CharlieProjects/MULTI-19/03 Electronics/Components Datasheet/02 Conveyor controller/GoldenMotor/VEC Controller Wiring Diagram.jpg

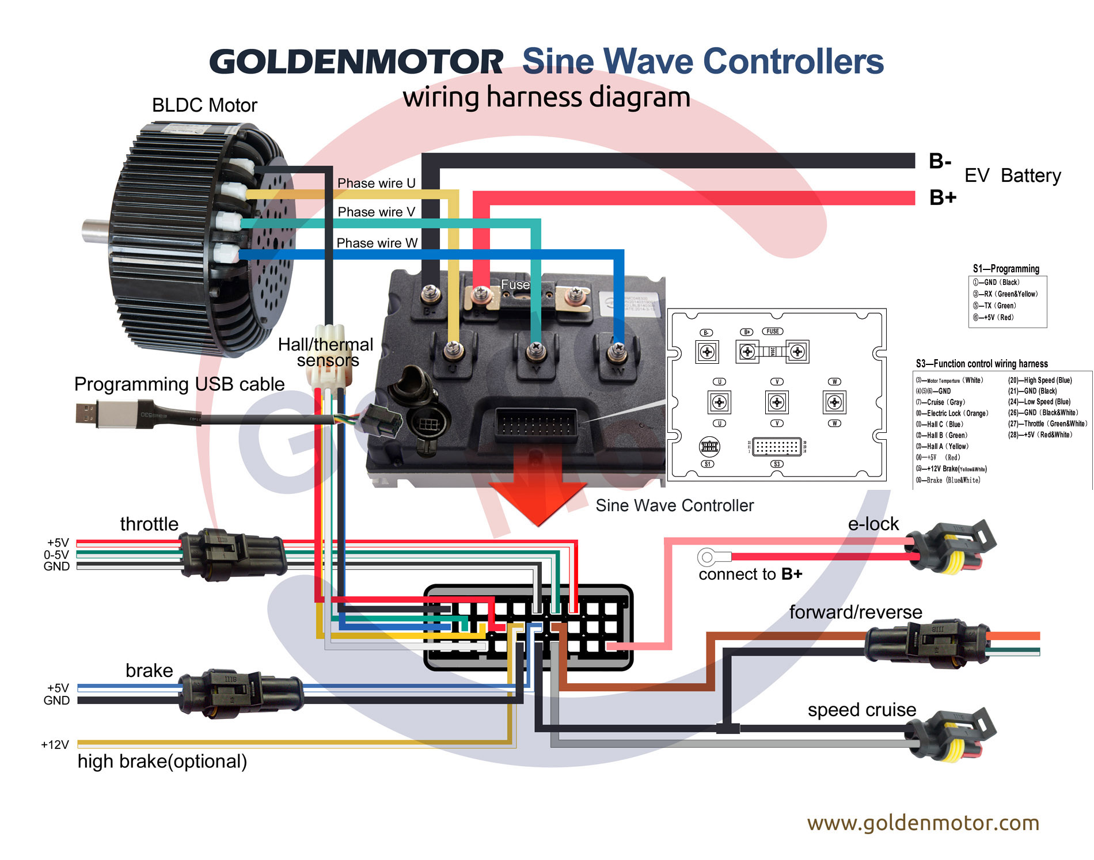
03 Electronics/Components Datasheet/02 Conveyor controller/GoldenMotor/VEC Controller Wiring Diagram.jpg
