CharlieProjects/MULTI-19/01 CAD/01 Main Model/01 Original/01 Main Model/Torno_rodillos/ELECTRONICA/arduino-nano-shield-cnc-1.snapshot.4 (1)/nano shield.png

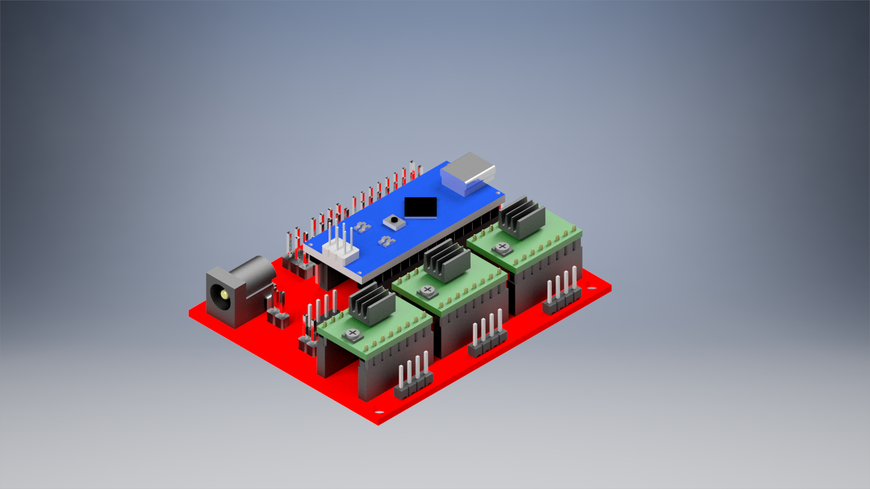
01 CAD/01 Main Model/01 Original/01 Main Model/Torno_rodillos/ELECTRONICA/arduino-nano-shield-cnc-1.snapshot.4 (1)/nano shield.png
