CharlieProjects/MULTI-19/README.md

# MULTI-19
This repository intends to organize the files related to the control of the conveyor belt of Multiplo Colombia S.A.S

[REPO](https://github.com/CharlieProjects/MULTI-19)

## Intro
