CharlieProjects/MULTI-19/00 Documents/05 Pictures/CONVEYOR v2.png

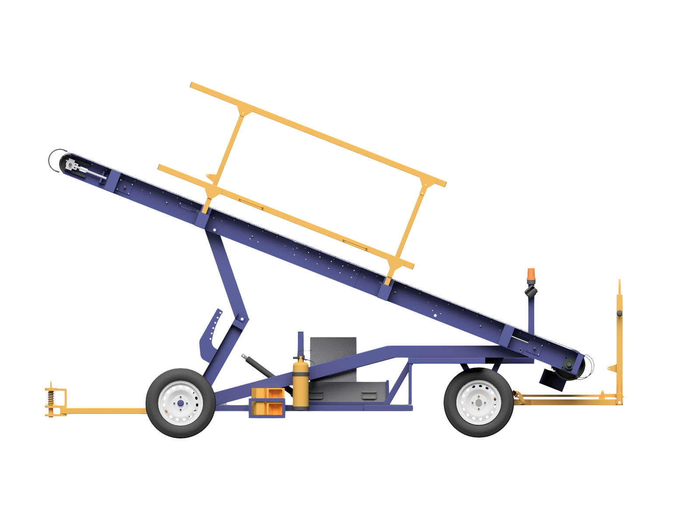
00 Documents/05 Pictures/CONVEYOR v2.png
