CharlieProjects/MULTI-19/00 Documents/05 Pictures/recorte_de pantalla-1.png

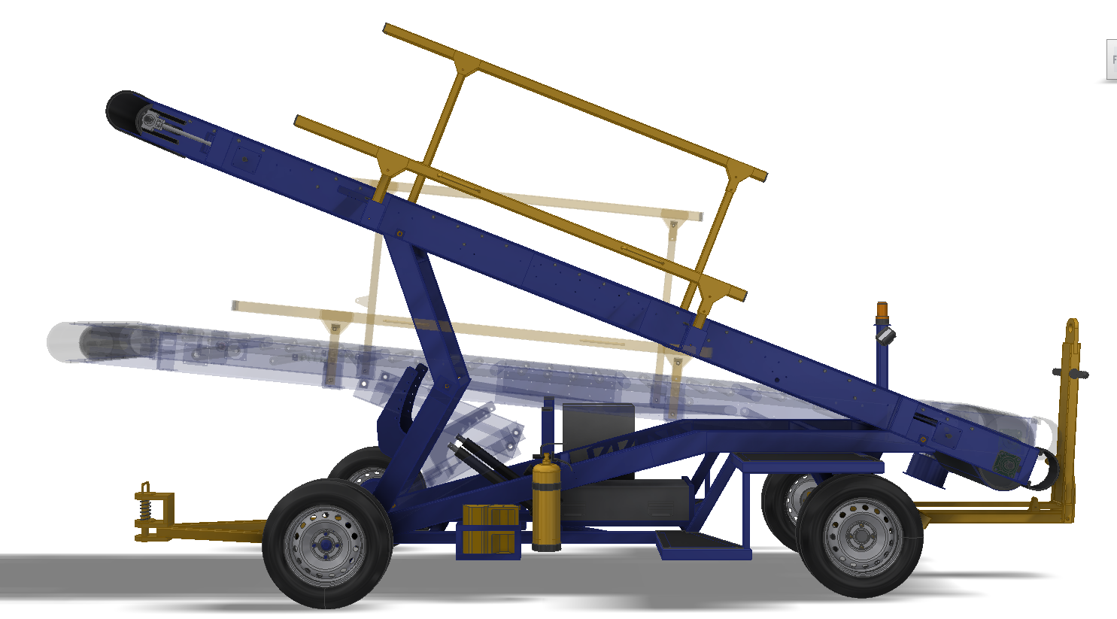
00 Documents/05 Pictures/recorte_de pantalla-1.png
