CharlieProjects/MULTI-19/00 Documents/05 Pictures/recorte_de pantalla-7.png

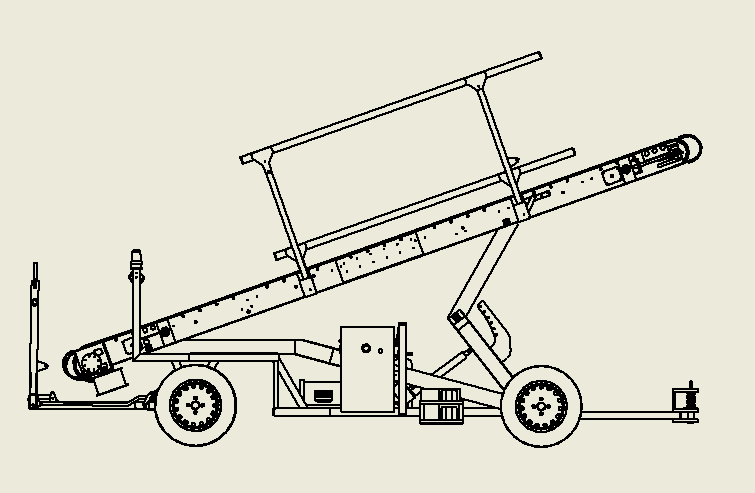
00 Documents/05 Pictures/recorte_de pantalla-7.png
