CharlieProjects/MULTI-19/00 Documents/05 Pictures/Untitled picture.png

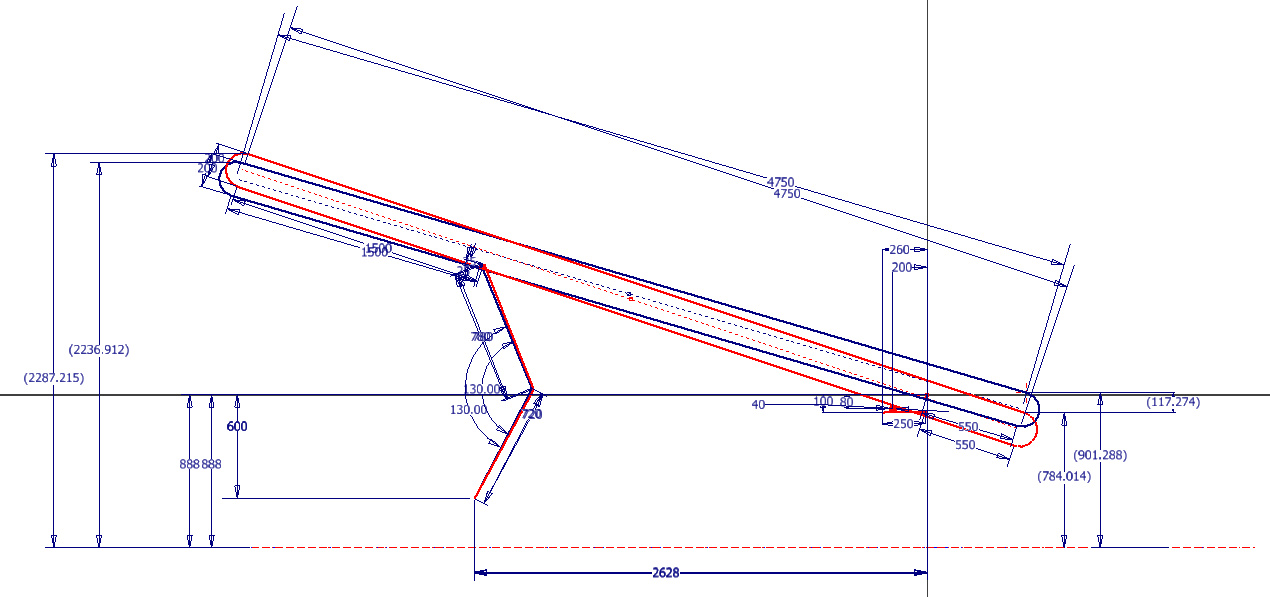
00 Documents/05 Pictures/Untitled picture.png
