CharlieProjects/MULTI-19/01 CAD/01 Main Model/01 Original/01 Main Model/Torno_rodillos/chinese-cnc-rotation-axis-module-with-80mm-chuck-1.snapshot.5/globe bot/80mm-CNC-4th-Axis-CNC-dividing-head-Rotation-Axis-A-axis-kit-for-Mini-CNC-router.jpg

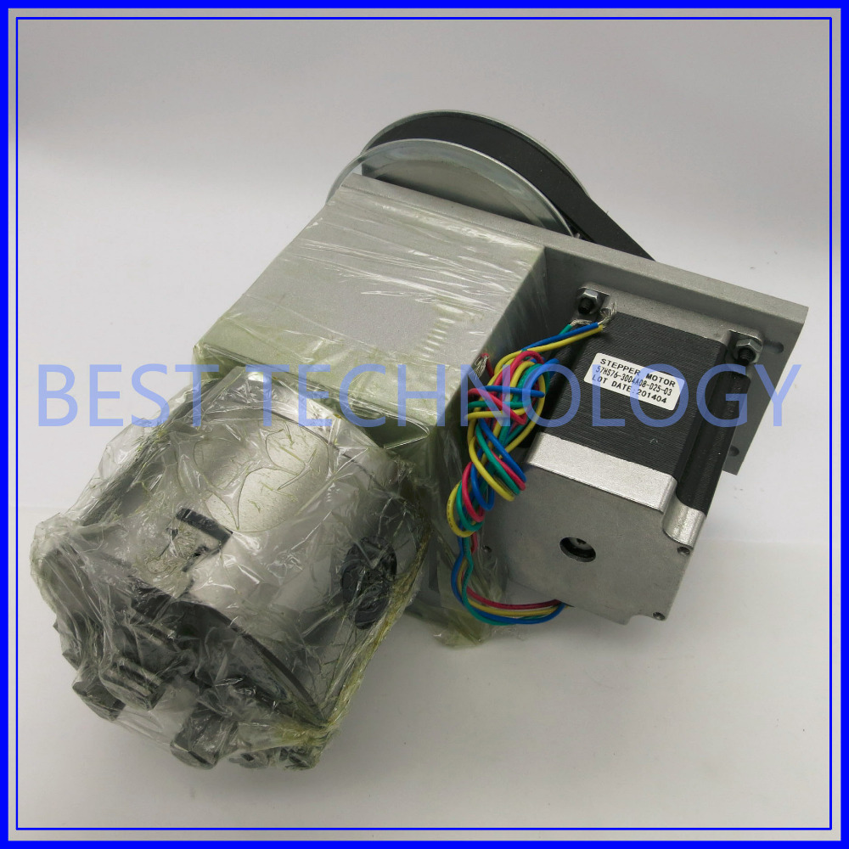
01 CAD/01 Main Model/01 Original/01 Main Model/Torno_rodillos/chinese-cnc-rotation-axis-module-with-80mm-chuck-1.snapshot.5/globe bot/80mm-CNC-4th-Axis-CNC-dividing-head-Rotation-Axis-A-axis-kit-for-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
