CharlieProjects/MULTI-19/01 CAD/01 Main Model/01 Original/01 Main Model/Torno_rodillos/chinese-cnc-rotation-axis-module-with-80mm-chuck-1.snapshot.5/globe bot/A_axis_right.JPG

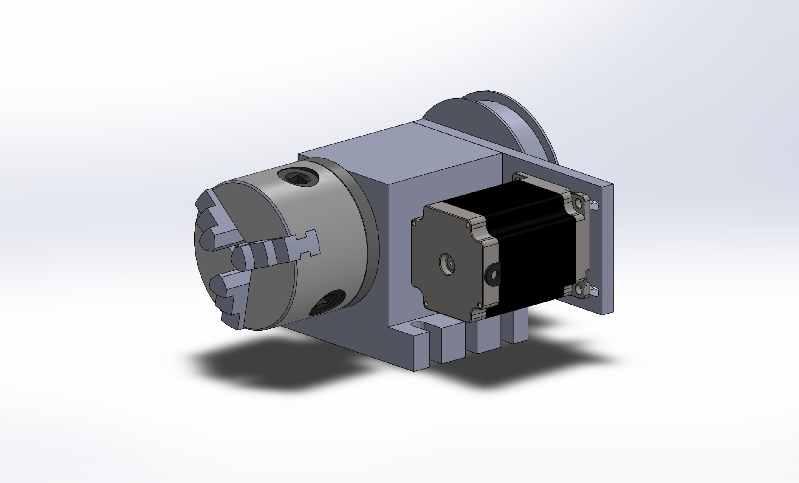
01 CAD/01 Main Model/01 Original/01 Main Model/Torno_rodillos/chinese-cnc-rotation-axis-module-with-80mm-chuck-1.snapshot.5/globe bot/A_axis_right.JPG
