CharlieProjects/MULTI-19/01 CAD/01 Main Model/01 Original/01 Main Model/Torno_rodillos/ELECTRONICA/Pulse power supply/Dimension.jpg

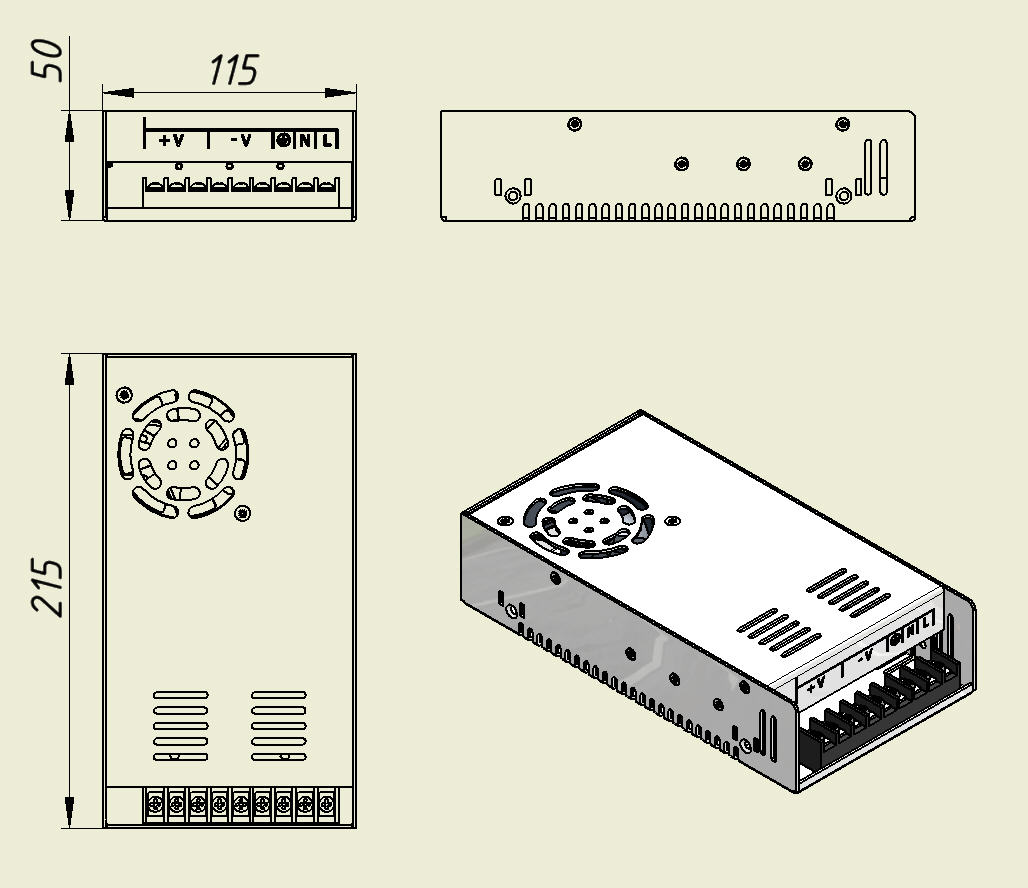
01 CAD/01 Main Model/01 Original/01 Main Model/Torno_rodillos/ELECTRONICA/Pulse power supply/Dimension.jpg
