CharlieProjects/MULTI-19/01 CAD/01 Main Model/01 Original/01 Main Model/Torno_rodillos/ELECTRONICA/Rotary Encoder EC11/Renders/EC11_knob.png

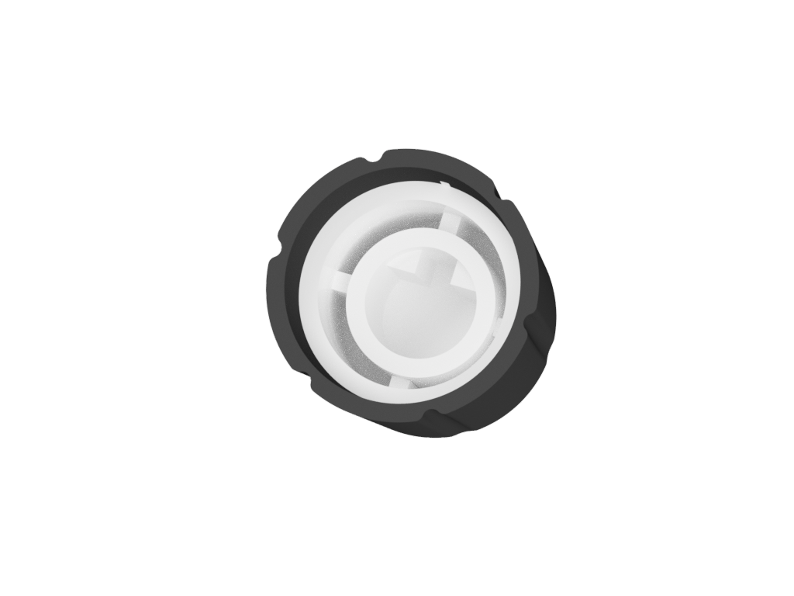
01 CAD/01 Main Model/01 Original/01 Main Model/Torno_rodillos/ELECTRONICA/Rotary Encoder EC11/Renders/EC11_knob.png
