CharlieProjects/MULTI-19/01 CAD/01 Main Model/01 Original/01 Main Model/Torno_rodillos/ELECTRONICA/SMAKN TB6600 STEPPER MOTOR DRIVER.JPG

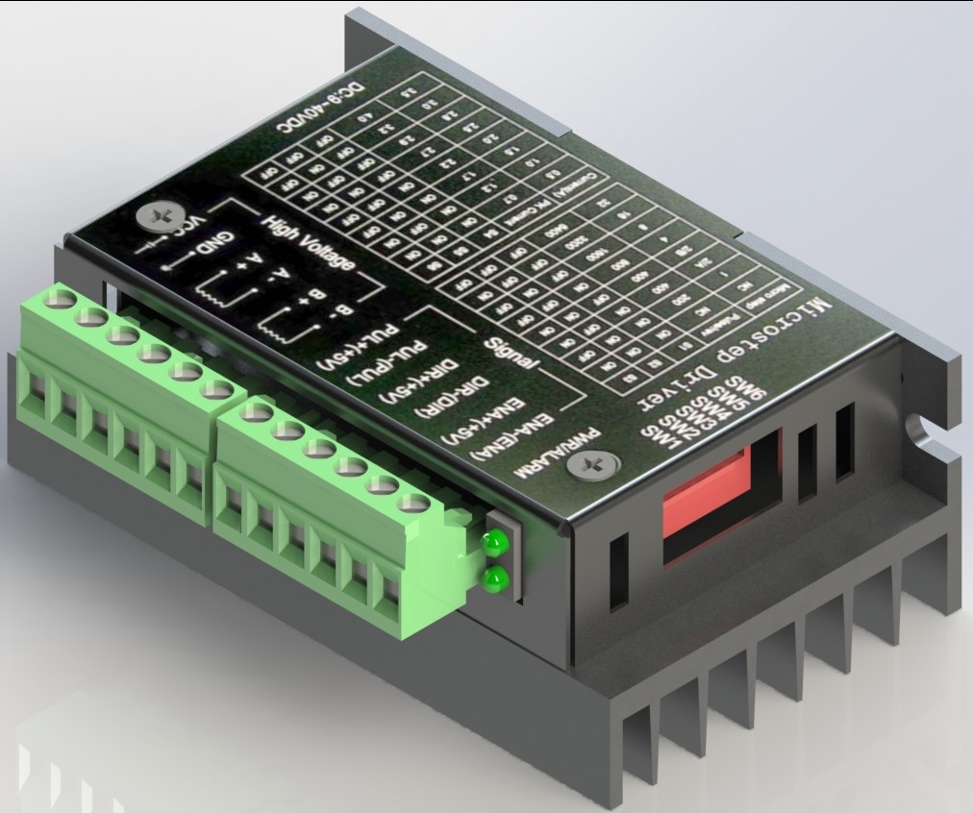
01 CAD/01 Main Model/01 Original/01 Main Model/Torno_rodillos/ELECTRONICA/SMAKN TB6600 STEPPER MOTOR DRIVER.JPG
