CharlieProjects/MULTI-19/01 CAD/01 Main Model/01 Original/01 Main Model/Torno_rodillos/mini-cnc-tailstock-1.snapshot.7/Renderings/MT0055.jpg

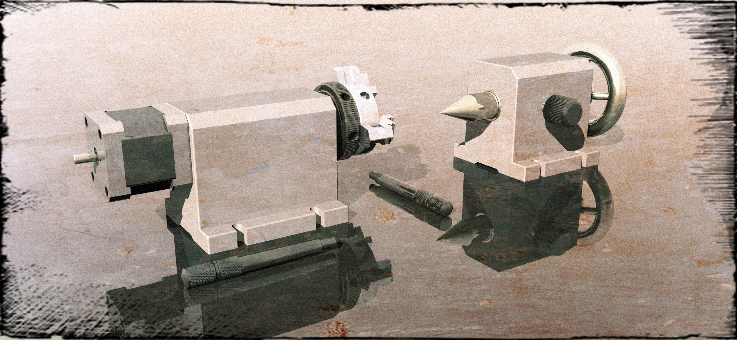
01 CAD/01 Main Model/01 Original/01 Main Model/Torno_rodillos/mini-cnc-tailstock-1.snapshot.7/Renderings/MT0055.jpg
