CharlieProjects/MULTI-19/01 CAD/01 Main Model/02 Modified/01 Main Model/MODIFIEDASM V2/rl-bi004-digital-led-state-battery-charge-indicator-12v-24v-24v-36v-48v-72v-and-digital-hour-meter-1.snapshot.1/RL-BI004 Digital LED State Battery Charge Indicator.JPG

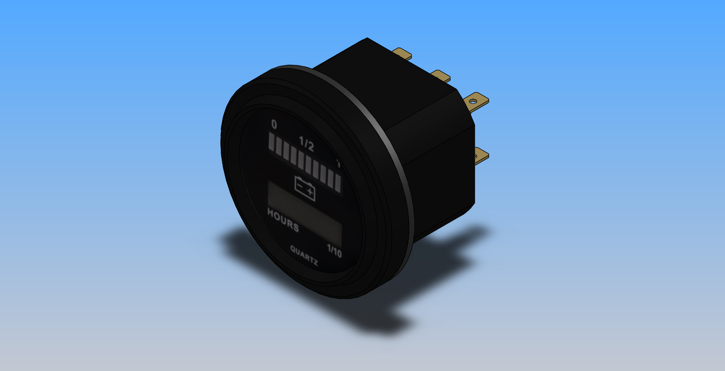
01 CAD/01 Main Model/02 Modified/01 Main Model/MODIFIEDASM V2/rl-bi004-digital-led-state-battery-charge-indicator-12v-24v-24v-36v-48v-72v-and-digital-hour-meter-1.snapshot.1/RL-BI004 Digital LED Stat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
