CharlieProjects/MULTI-19/00 Documents/02 Calculations/Control Components BOM.xlsx

Sheet: Selection tables
 | DC-DC (48 to 12)
 |  | DETAILS |  |  |  | CUSTOMERS REVIEW |  |  |  |  | INPUT |  |  | OUTPUT |  |  |  | POWER |  | EXTRAS |  |  | DOCUMENTATION & SUPPORT
 |  | Component | Image | Referencia | Manufacturer | Plataform | ASIN | Price | Review | Reviewers | Min voltage [V] | Max voltage [V] | Nominal [V] | Min voltage [V] | Max voltage [V] | Nominal [V] | Max Current [A] | Working Power [W] | Max Power [W] | Key pin | Input fuse |  | Datasheet | Support | CAD
 |  |  |  | Yes |  |  |  | $60.00 | 4.5 | 100 | 36 | 60 | 48 | 11.5 | 12.5 | EXACT 12 | 20 | 200 | 250 | Nice to have | Nice to have |  | Yes | Yes | Yes
 |  |  |  | 1 | 0 |  | 0 | -1 | 1 | 1 | -1 | 1 | 0 | 0 | 0 | 0 | 1 | 1 | 1 | 0 | 0
. | INDEX | Component | Image | Referencia | Manufacturer | Plataform | ASIN | Price | Review | Reviewers | Min voltage [V] | Max voltage [V] | Nominal [V] | Min voltage [V]2 | Max voltage [V]3 | Nominal [V]4 | Max Current [A] | Working Power [W] | Max Power [W] | Key pin | Input fuse | Column5 | Datasheet | Support | CAD | PASS | NOTES
__________________ | 1 | Pro Case 180W DC/DC (https://www.amazon.com/dp/B07GNTC1D7/?coliid=I162X8DYW6NY0M&colid=3OOX75RIROCEH) |  |  | Pro Chaser | Amazon | B07GNTC1D7 | $22.90 | 4.4 | 470 | 48 | 72 | N/A | 11 | 13 | 12 | 15 | Not specified | 180 | 1 | 0 |  | 0 |  | 0 | NO | - No diode in the input of the circuit board it drains a batteri even with the key switch off - End connector not standarized. - Voltage output not stable +-1V
__________________ | 2 | Pro Case 240W DC/DC (https://www.amazon.com/dp/B07S6G4Q66/?coliid=I1HOY8ASPYI8WU&colid=3OOX75RIROCEH) |  | PC3648-20amp | Pro Chaser | Amazon | B07GNTC1D7 | $22.99 | 4.4 | 481 | 48 | 72 | N/A | 11.5 | 12 | 12 | 20 | Not specified | 240 | 1 | 1 |  | 0 |  | 0 | NO | -No input protections - Works at a higth temperature even at 60% capacity. - Could foail within 2 months (Unstable).
__________________ | 3 | LEDMO 48V (https://www.amazon.com/dp/B089YBPHM1/?coliid=I1U5WC5LP32ZP8&colid=3OOX75RIROCEH) |  | B089YBPHM1 | LEDMO | Amazon | B089YBPHM1 | $20.99 | 4.6 | 283 | 48 | 48 | N/A | 12 | 12 | 12 | 20 | Not specified | 240 | 0 | 0 |  | 0 | 1 | GrabCAD (https://grabcad.com/library/dc-dc-buck-converter-step-down-15-90vdc-in-out-12vdc-20a-1) | PLAUSIBLE WITH CAUTION | -The 48V coud work well, but some suppliers confuse this model with the 24V version (WARNING!!!) -Test how it works with 37V to check performance with low battery.
__________________ | 4 | ROYKAW (https://www.amazon.com/Roykaw-Voltage-Reducer-Regulator-Converter/dp/B086C32FK1) |  | E-Z-GO DC-DC | ROYKAW | Amazon | B086C32FK1 | $64.90 | 4.6 | 144 | 36 | 48 | N/A |  | 12 | 12 | 30 | Not specified | 360 | 1 |  |  |  | 1 | 0 | YES
__________________ | 5 | 60A 720W 12v Golf Cart 48V 36V (https://www.amazon.com/720W-Converter-Voltage-Regulator-Waterproof/dp/B081GMD5HZ) |  |  |  | Amazon |  | $96.99 | 4.6 | 60 | 36 | 48 | N/A | 12 | 12 | 12 | 60 |  | 720 | 0 | 0 |  |  |  |  | YES
__________________ | 6 | HOMELYLIFE 600W DC 48V 60V (https://www.amazon.com/72V-12V-50A-Waterproof-Transformer/dp/B08THF63MQ) |  | j48607212GL600E | TOBSUN | Amazon | B08THF63MQ | $95.00 | 4.7 | 2166 | 48 | 72 | N/A | 12 | 12 | 12 | 50 | 600 | 700 | 1 | 1 |  | 0 | 1 | 0 | PLAUSIBLE WITH CAUTION | The equipment description seams to work but all the reviews from this vendor seams to be talking abot a another model.
__________________ | 7
__________________ | 8
__________________ | 9
__________________ | 10 |  |  |  |  |  |  |  |  |  |  |  | N/A |  |  | 12
 | DC MOTOR SPEED CONTROLLES
 |  | DETAILS |  |  |  | CUSTOMERS REVIEW |  |  |  |  | INPUT |  |  | OUTPUT |  |  |  | POWER |  | EXTRAS |  |  | DOCUMENTATION & SUPPORT
 |  | Component | Image | Referencia | Manufacturer | Plataform | ASIN | Price | Review | Reviewers | Min voltage [V] | Max voltage [V] | Nominal [V] | Min voltage [V] | Max voltage [V] | Nominal [V] | Max Current [A] | Working Power [W] | Max Power [W] | Frecuency | Input fuse |  | Datasheet | Support | CAD
 |  |  |  | Yes |  |  |  | $30.00 | 4.5 | 100 | 36 | 60 | 48 | 11.5 | 12.5 | EXACT 12 | 20 | 200 | 250 | Not defined | Nice to have |  | Yes | Yes | Yes
 |  |  |  | 1 | 0 |  | 0 | -1 | 1 | 1 | -1 | 1 | 0 | 0 | 0 | 0 | 1 | 1 | 1 | 1 | 0
Column1 | INDEX | Component | Image | Referencia | Manufacturer | Plataform | ASIN | Price | Review | Reviewers | Min voltage [V] | Max voltage [V] | Nominal [V] | Min voltage [V]2 | Max voltage [V]3 | Nominal [V]4 | Max Current [A] | Working Power [W] | Max Power [W] | Frecuency | Input fuse | Column5 | Datasheet | Support | CAD | PASS | NOTES
__________________ | 1 | KLC Universal DC Motor speed controller (https://www.amazon.com/dp/B07R3BMPHF/?coliid=IAQ23EJLPOARO&colid=3OOX75RIROCEH) |  | Keenso98thg1qemx | Keenso | Amazon | B07R3BMPHF | $30.57 | 3.4 | 16 | 6 | 90 | N/A | 6 | 90 | N/A | 15 |  | 1000 | 16KHz |  |  | 0 | 1 |  | YES | -Input protection Aftersale service
__________________ | 2 | DC- 6-60V (https://www.amazon.com/dp/B078TC25LS/?coliid=ISRP4IO2G9XKT&colid=3OOX75RIROCEH) |  |  |  | Amazon | B078TC25LS | $23.46 | 4.2 | 115 | 6 | 60 | N/A | 6 | 60 | N/A | 30 |  |  | yes no specified |  |  | 0 | 0 | 0 | PLAUSIBLE
__________________ | 3 | Centaurus DC Motor controller (https://www.amazon.com/dp/B09FXCJP47/?coliid=I22P3ZZQ27S5P1&colid=3OOX75RIROCEH) |  |  | CE CENTAURUS ELECTRONICS | Amazon | B09FXCJP47 | $28.99 | N/A | N/A | 10 | 55 | N/A |  |  | N/A | 60 |  |  | 15KHz |  |  | 1 |  | 0 |  | - from Tajikistan
__________________ | 4 | Stepless DC motor controller (https://www.amazon.com/dp/B01M5F5UDS/?coliid=I19X83N9C4TYCI&colid=3OOX75RIROCEH) |  | 2126efef26m357 |  | Amazon | B01M5F5UDS | $27.99 | 4 | 131 | 10 | 55 | N/A | 12 | 48 | N/A | 60 | 2500 | 4800 |  |  |  | 0 | 0 | Generic enclosure GrabCAD (https://grabcad.com/library/dc-switch-mode-power-supply-1) | PLAUSIBLE WITH CAUTION | - No vendor support. - No instructions included. -Check the working and the max power (thos numbers doesent seams ral).
__________________ | 5 | L&Z DC Motor (https://www.amazon.com/Motor-Controller-Adjustment-Control-Module/dp/B092J49LFS?s=industrial) |  |  |  | Amazon |  | $29.00 | 4 | 9 | 6 | 90 | N/A | 6 | 90 | N/A | 15 |  | 1000 |  |  |  | 0 | 1 | 0 | YES | - 8A recommended working current. -15A max current
__________________ | 6 | GSD1-48-20C (https://www.automationdirect.com/adc/shopping/catalog/drives_-a-_soft_starters/dc_drives/low_voltage_(%3C_50v)/open_frame/gsd1-48-20c) |  | GSD1-48-20C | IRONHORSE | Automation Direct |  | $208.00 | No info | 0 | 12 | 48 | N/A | 12 | 48 | N/A | 20 |  |  | 18KHz | 0 |  | 1 |  | AutomationDirect (https://www.automationdirect.com/adc/shopping/catalog/drives_-a-_soft_starters/dc_drives/low_voltage_(%3C_50v)/open_frame/gsd1-48-20c) | YES
__________________ | 7 | EM-282C-48V (https://electromen.com/en/products/item/motor-controllers/dc-motor/EM-282C-48V) |  | EM-282C-48V |  |  |  | requires quote | no info | no info | 24 | 48 | N/A | 24 | 48 | N/A | 80 |  |  | 2KHz-16KHz | 0 |  | 1 | 1 | 0 | YES
__________________ | 8 |  |  |  |  |  |  |  |  |  |  |  | N/A |  |  | N/A
__________________ | 9 |  |  |  |  |  |  |  |  |  |  |  | N/A |  |  | N/A
__________________ | 10 |  |  |  |  |  |  |  |  |  |  |  | N/A |  |  | N/A
 | Power switch actuator (Relay VS SSR)
 |  | DETAILS |  |  |  | CUSTOMERS REVIEW |  |  |  |  | INPUT (COIL) |  |  | OUTPUT |  |  |  | POWER |  | EXTRAS |  |  | DOCUMENTATION & SUPPORT
 |  | Component | Image | Referencia | Manufacturer | Plataform | ASIN | Price | Review | Reviewers | Min voltage [V] | Max voltage [V] | Nominal [V] | Min voltage [V] | Max voltage [V] | Nominal [V] | Max Current [A] | Working Power [W] | Max Power [W] | Key pin | Input fuse |  | Datasheet | Support | CAD
 |  |  |  | Yes |  |  |  | $60.00 | 4.5 | 100 | 36 | 60 | 48 | 11.5 | 12.5 | EXACT 12 | 20 | 200 | 250 | Nice to have | Nice to have |  | Yes | Yes | Yes
 |  |  |  | 1 | 0 |  | 0 | -1 | 1 | 1 | -1 | 1 | 0 | 0 | 0 | 0 | 1 | 1 | 1 | 0 | 0
. | INDEX | Component | Image | Referencia | Manufacturer | Plataform | ASIN | Price | Review | Reviewers | Min voltage [V] | Max voltage [V] | Nominal [V] | Min voltage [V]2 | Max voltage [V]3 | Nominal [V]4 | Max Current [A] | Working Power [W] | Max Power [W] | SSR | Column2 | Column3 | Datasheet | Support | CAD | PASS | NOTES
__________________ | 1 | CG Solid State Relay SSR-100DD (https://www.amazon.com/dp/B08GP328LH/?coliid=I21HMTJ13RI35Z&colid=3OOX75RIROCEH) |  |  |  | Amazon |  |  |  |  |  |  | N/A |  |  | N/A |  | N/A |  | 1 |  |  |  |  |  | YES
__________________ | 2 | CG Solid State Relay SSR-100DD (https://www.amazon.com/dp/B08GP328LH/?coliid=I21HMTJ13RI35Z&colid=3OOX75RIROCEH) |  |  |  | Amazon |  | $16.90 | 4 | 119 |  |  | N/A |  |  | N/A |  | N/A |  | 1 |  |  |  |  |  | YES
__________________ | 3 | TWTADE SSR-40 DD 40A DC 3-32V to DC 5-60V SSR Solid State Relay (https://www.amazon.com/dp/B079BGGVYX/?coliid=ITFC18LQYP46Q&colid=3OOX75RIROCEH) |  |  |  | Amazon |  | $16.90 | 4.4 | 320 | 3 | 32 | 24 |  |  | N/A |  | N/A |  | 1 |  |  |  |  |  | YES
__________________ | 4 | Migro 40 Amp 2 Pole NEMA 600V HVAC Heavy Duty (https://www.amazon.com/Migro-Heavy-Definite-Purpose-Contactor/dp/B07ZTP3Z71?s=industrial) |  |  |  | Amazon |  | $21.99 | 4.6 | 35 |  |  | 24 | 0 |  | N/A | 50 | N/A |  | 0 |  |  |  |  |  | YES
__________________ | 5 | Household Contactor, AC Contactor 4NO (https://www.amazon.com/Household-Contactor-Mounting-Electrical-Accessories/dp/B08QNC17FH) |  | BCH8-E63/40 | THINCOL | Amazon |  | $34.88 | 4 | 1 | 12 | 100 | N/A | 0 |  | N/A | 100 | N/A | 4000 | 0 |  |  | 1 | 1 | 1 | YES | -Rail DIN -Stable and reliable. -Price could be lower.
__________________ | 6
__________________ | 7
__________________ | 8
__________________ | 9
__________________ | 10

Sheet: Sheet1
R1 | 1000 |  | L1 (24V) | 5 | Amp
R2 | 1000 |  | L2 (14V) | 20 | Amp
R3 | 1000
R4 | 1000
 | Min | Max | Aver |  |  | Min | Max | Aver | Power
Vin | 36 | 55 | 48 |  | A R1 | 0.018 | 0.0275 | 0.024
V "24" | 18 | 27.5 | 24 |  | A R2 | 0.018 | 0.0275 | 0.024
V "12" | 9 | 13.75 | 12 |  | A R3 | 0.009 | 0.01375 | 0.012 | 0.144
 |  |  |  |  | A R4 | 0.009 | 0.01375 | 0.012
 |  |  |  |  | A R4' | 15.009 | 22.93041667 | 20.012 | 240.144
 |  |  |  |  | AR3' | 0.01798921294 | 0.02748351978 | 0.02398561726
R L1 | 4.8
R L2 | 0.6
R4' | 0.5996402159
R3' | 1000.59964
 | 20012 |  |  |  |  |  | 47
 |  |  |  |  |  |  | 23.5

Sheet: Components
 | Reference | Manufacturer | Price | Selected | Update | Datasheet | Note
Main Battery
Fuse Box
Auxiliar battery
Main voltage regulator | DrRN40-48 (https://www.mouser.com/ProductDetail/MEAN-WELL/DRDN40-48?qs=BJlw7L4Cy7%252BBpvS4OtLDzQ%3D%3D&mgh=1) | Mean Well | 46.32 |  |  | https://www.meanwell.com/webapp/product/search.aspx?prod=DRDN40#1
Main Controll board
Power 12V DC-DC
Auxiliar 12V DC-DC
Contactor
48V DC motor controller | EM-282C-48V
Elevation Actuator | YNT-04 | Nanjing YongNuo Transmission Equipment CO.,LTd.
Conveyor controller
Conveyor motor
Beacon ligth
Auxiliar ligth
