CharlieProjects/MULTI-19/00 Documents/02 Calculations/Control MULTI-19.xlsx

Sheet: IO
 |  | ENTRADAS |  |  |  |  |  | SALIDAS
Indice | Nombre descriptivo | Nombre en codigo | Tipo | Voltaje | Puerto | Indice | Nombre descriptivo | Nombre en codigo | Tipo | Voltaje | Puerto
1 | Encendido Maquina | START | Booleana | 12 |  | 1 | Motor Elevacion UP | UP | Booleana | 48
2 | Luz Beacon | Sw_Beacon | Booleana | 12 |  | 2 | Motor Elevacion DOWN | DOWN | Booleana | 48
3 | Luz Reflector | Sw_Reflector | Booleana | 12 |  | 3 | Motor Banda FWD | FWR | Booleana | 5 | ???
4 | Control Banda FWD | Sw_FWR | Booleana | 12 |  | 4 | Motor Banda RWD | RWD | Booleana | 5 | ???
5 | Control Banda STOP | STOP | Booleana | 12 |  | 5 | Luz Beacon |  | Booleana | 12
6 | Control Bnada RWD | Sw_RWD | Booleana | 12 |  | 6 | Luz Reflector |  | Booleana | 12
7 | Control Elevador UP | SwUP | Booleana | 12 |  | 7 | Luz estado Bateria 1 |  | Booleana
8 | Control Elevador DOWN | swDOWN | Booleana | 12 |  | 8 | Luz estado Bateria 2 |  | Booleana
9 | Fin de carrera | finalCarrera | Booleana | 12 |  | 9 | Luz estado general 1 |  | Booleana
10 | Entrada Extra Puls1 | Sw1 | Booleana | 12 |  | 10 | Lus estado general 2 |  | Booleana
11 | Entrada Extra Puls2 | Sw2 | Booleana | 12
12 | Entrada Extra Puls3 | Sw3 | Booleana | 12
13 | Entrada Extra Puls4 | Sw4 | Booleana | 12
14 | Shunt | SHUNT | Analoga | 12
15 | DHT-22 Temperatura | Temp | Analoga | 12
16 | DHT-22 Humedad | Hum | Analoga | 12
17 | GPS | GPS | Analoga | - | RS-485
18 | RTC | RTC | PWM | 5 | I2C
19 | LoRaWan | LoRaWan | PWM | 5 | RS-485

Sheet: Componentes
TRM | 3760.38 |  |  |  |  |  | $21432617.52 | COP
Impuesto | 20%
Proveedor | Contacto | Descripcion | Componente | Cantidad | Precio | Divisa | Subtotal [COP] | URL
 |  |  | Honorarios | 1 | $6720000.00 | COP | $6720000.00
NORVI |  | MCU Central | NORVI ARITA | 10 | $169.00 | USD | $7626050.64
NORVI |  | MCU comunicaciones | NORVI Agente 1 | 10 | $81.00 | USD | $3655089.36
Aliexpress |  |  | DC-DC 48-24v | 10 | $10.00 | USD | $451245.60 | https://www.aliexpress.com/item/4000555918684.html | https://www.aliexpress.com/item/32383492278.html
Aliexpress |  |  | Coaxial para antena | 10 | $7.00 | USD | $315871.92
Local |  | Para aislar la beteria | Breaker dual | 10 | $35000.00 | COP | $350000.00
I+D |  |  | Porta fusibles | 30 | $7378.00 | COP | $221340.00 | https://www.aliexpress.com/item/33049858450.html
 |  |  | Riel DIN 1m | 10 | $12000.00 | COP | $120000.00
 |  |  | Terminal de distribucion | 30 | $18564.00 | COP | $556920.00
 |  |  | Tarjeta de reles DIN | 10 | $90440.00 | COP | $904400.00
 |  |  | Tarjeta de borneras 20 pines | 10 | $51170.00 | COP | $511700.00
 |  |  | Excedente de seguridad 30% | 1 | $6429785.26 | COP | $6429785.26
 |  |  | TOTAL | $27862402.78
 |  |  |  |  |  |  | $21142402.78
 |  |  |  |  |  |  | $2114240.28
