CharlieProjects/MULTI-19/01 CAD/01 Main Model/01 Original/01 Main Model/Torno_rodillos/chinese-cnc-rotation-axis-module-with-80mm-chuck-1.snapshot.5/globe bot/A_axis_right.SLDASM

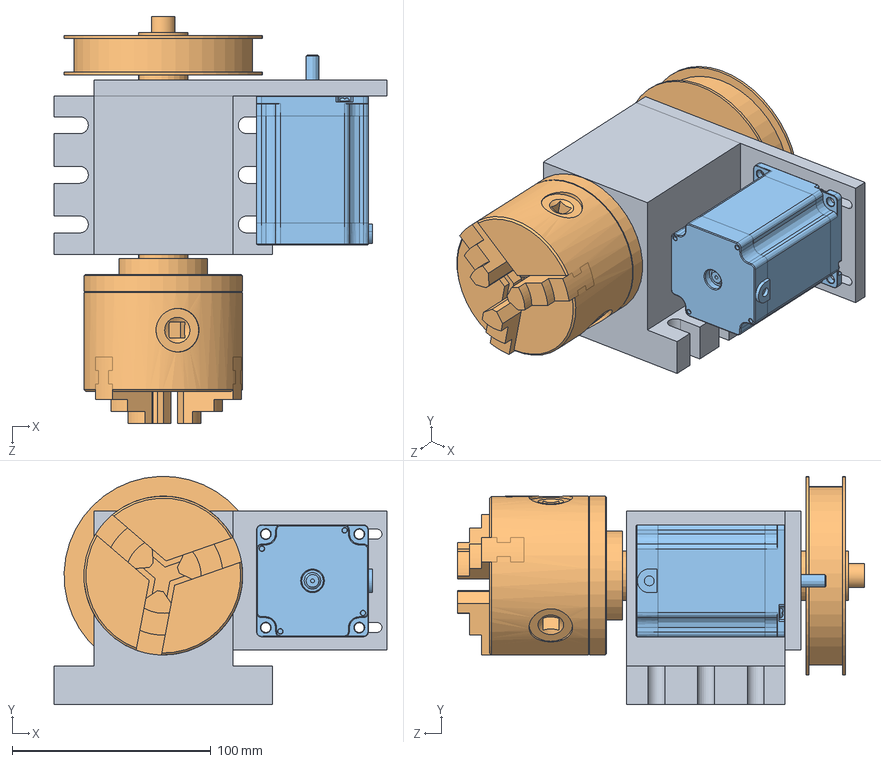
[picture p43: CAD file, 2022-03-21]
01 CAD/01 Main Model/01 Original/01 Main Model/Torno_rodillos/chinese-cnc-rotation-axis-module-with-80mm-chuck-1.snapshot.5/globe bot/A_axis_right.SLDASM
167.6 x 115.0 x 205.0 mm
a axis braket
chuck
Stepper motor NEMA 23HS7430
