CharlieProjects/MULTI-19/01 CAD/01 Main Model/01 Original/01 Main Model/Torno_rodillos/ELECTRONICA/16-x-2-lcd-display-module-with-iic-i2c-module-1.snapshot.1/LCD WITH IIC/i2c board.SLDASM

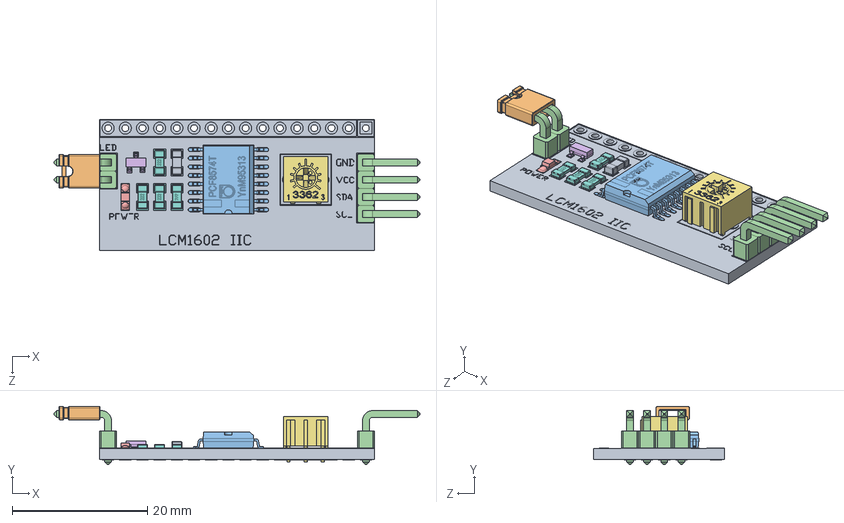
[picture p44: CAD file, 2022-03-21]
01 CAD/01 Main Model/01 Original/01 Main Model/Torno_rodillos/ELECTRONICA/16-x-2-lcd-display-module-with-iic-i2c-module-1.snapshot.1/LCD WITH IIC/i2c board.SLDASM
54.1 x 8.62 x 19.4 mm
i2C board
jumper__
pcf8574p
bent header x 6
led
ssot3
trimpot 3662
smt_resistor222 x 4
smt_cap
