CharlieProjects/MULTI-19/01 CAD/01 Main Model/01 Original/01 Main Model/Torno_rodillos/ELECTRONICA/16-x-2-lcd-display-module-with-iic-i2c-module-1.snapshot.1/LCD WITH IIC/LCD.SLDASM

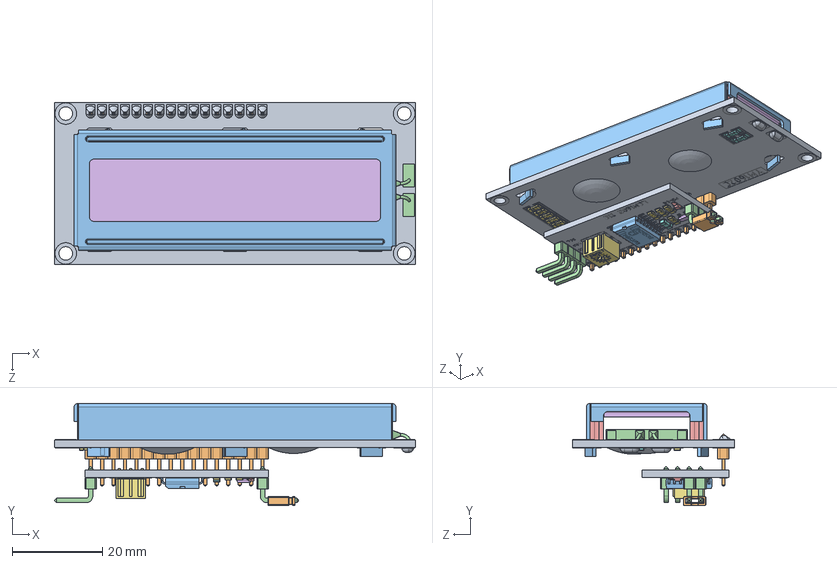
[picture p46: CAD file, 2022-03-21]
01 CAD/01 Main Model/01 Original/01 Main Model/Torno_rodillos/ELECTRONICA/16-x-2-lcd-display-module-with-iic-i2c-module-1.snapshot.1/LCD WITH IIC/LCD.SLDASM
80.0 x 22.6 x 36.0 mm
pcbboard
16pin_header__
lcd window
backlight
conductor x 2
liquid crystal grabcad i2s
smt_resistor222 x 10
smt_resistor101 x 2
i2C board
jumper__
pcf8574p
bent header x 6
led
ssot3
trimpot 3662
smt_cap
