CharlieProjects/MULTI-19/01 CAD/01 Main Model/01 Original/01 Main Model/Torno_rodillos/chinese-cnc-rotation-axis-module-with-80mm-chuck-1.snapshot.5/globe bot/chuck.SLDPRT

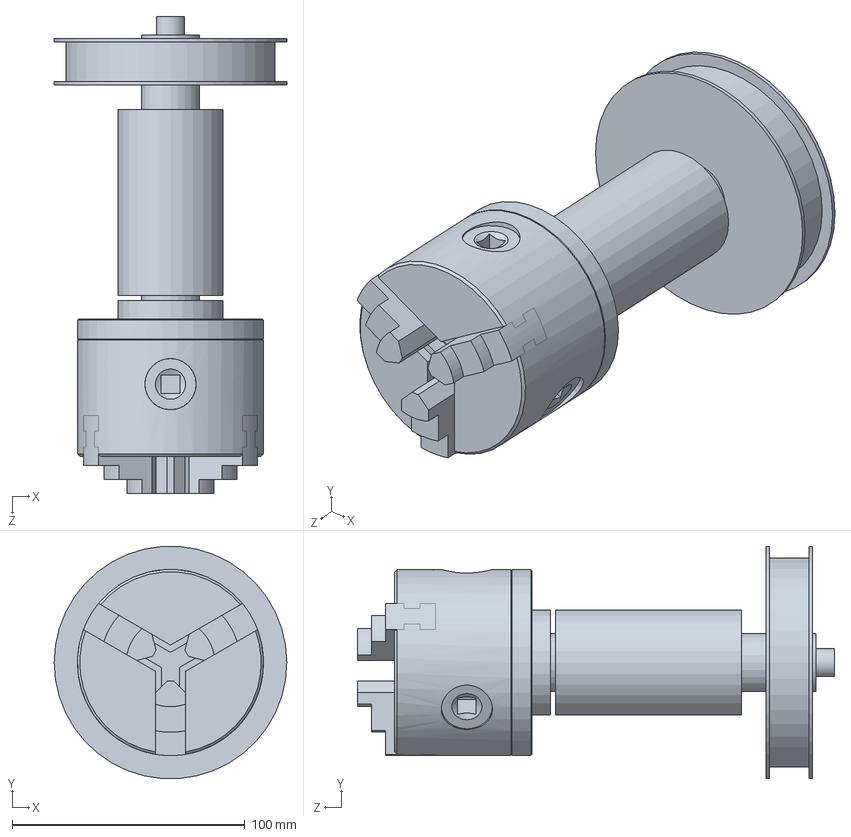
[picture p47: CAD file, 2022-03-21]
01 CAD/01 Main Model/01 Original/01 Main Model/Torno_rodillos/chinese-cnc-rotation-axis-module-with-80mm-chuck-1.snapshot.5/globe bot/chuck.SLDPRT
100.0 x 99.7 x 205.0 mm
