CharlieProjects/MULTI-19/01 CAD/01 Main Model/01 Original/01 Main Model/Torno_rodillos/ELECTRONICA/16-x-2-lcd-display-module-with-iic-i2c-module-1.snapshot.1/LCD WITH IIC/bent header.SLDPRT

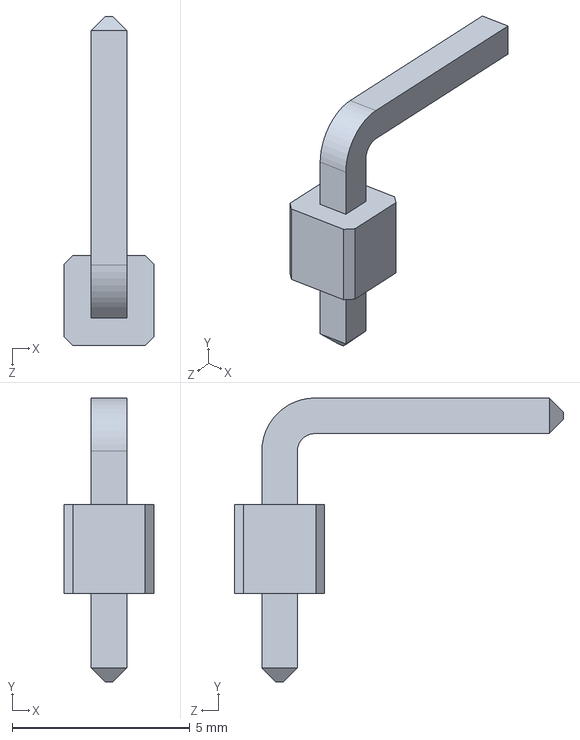
[picture p48: CAD file, 2022-03-21]
01 CAD/01 Main Model/01 Original/01 Main Model/Torno_rodillos/ELECTRONICA/16-x-2-lcd-display-module-with-iic-i2c-module-1.snapshot.1/LCD WITH IIC/bent header.SLDPRT
2.54 x 8.00 x 9.27 mm
