CharlieProjects/MULTI-19/01 CAD/01 Main Model/01 Original/01 Main Model/Torno_rodillos/ELECTRONICA/arduino-nano-shield-cnc-1.snapshot.4 (1)/nano shield.stp

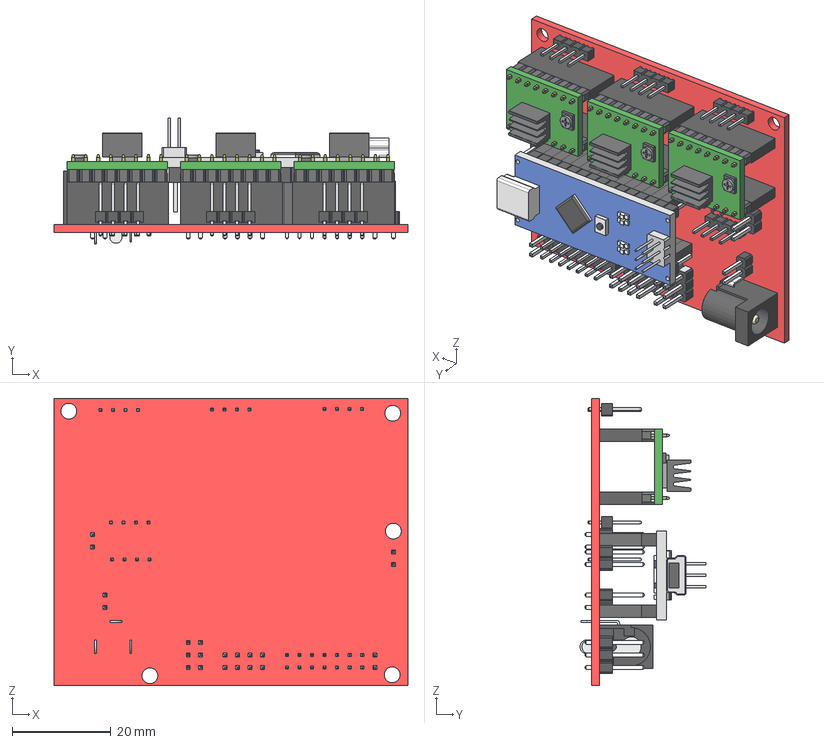
[picture p49: CAD file, 2022-03-21]
01 CAD/01 Main Model/01 Original/01 Main Model/Torno_rodillos/ELECTRONICA/arduino-nano-shield-cnc-1.snapshot.4 (1)/nano shield.stp
71.7 x 25.5 x 58.1 mm
nano
PZ_header_single_1pin x 10
PZ_header14pines
PZ_header_single_3pines x 4
User Library-Header 4 Vertical x 5
2.1mm DC Power Socket Housing
2.1mm DC Power Socket Pin
Terminal 1
Terminal 2
Terminal 3
2.5mm Pitch Miniature Socket - Digital x 6
pololu x 3
SIL_Socket_Body x 30
Arduino Nano
