CharlieProjects/MULTI-19/01 CAD/01 Main Model/01 Original/01 Main Model/Torno_rodillos/ELECTRONICA/EUROSTYLE TERMINAL BLOCK 6 POS 5.0 MM RA PLUG, SMAKN TB6600 STEPPER MOTOR DRIVER.SLDPRT

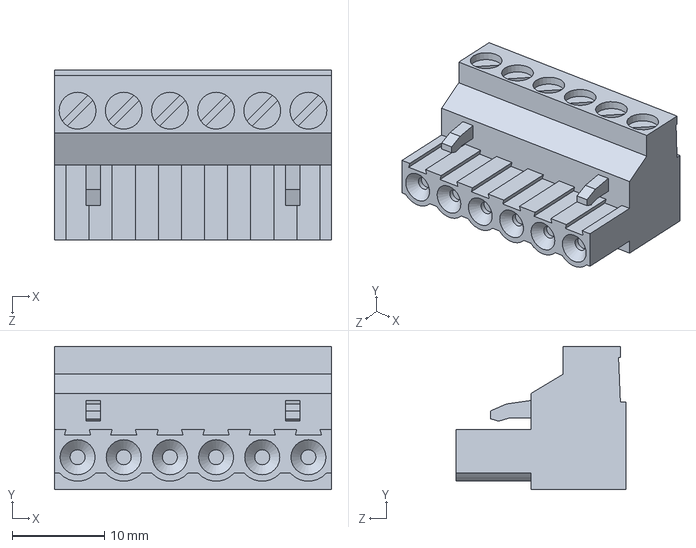
[picture p50: CAD file, 2022-03-21]
01 CAD/01 Main Model/01 Original/01 Main Model/Torno_rodillos/ELECTRONICA/EUROSTYLE TERMINAL BLOCK 6 POS 5.0 MM RA PLUG, SMAKN TB6600 STEPPER MOTOR DRIVER.SLDPRT
30.0 x 15.5 x 18.4 mm
