CharlieProjects/MULTI-19/01 CAD/01 Main Model/01 Original/01 Main Model/Torno_rodillos/ELECTRONICA/Pulse power supply/Pulse_power_supply_36V_600W.stp

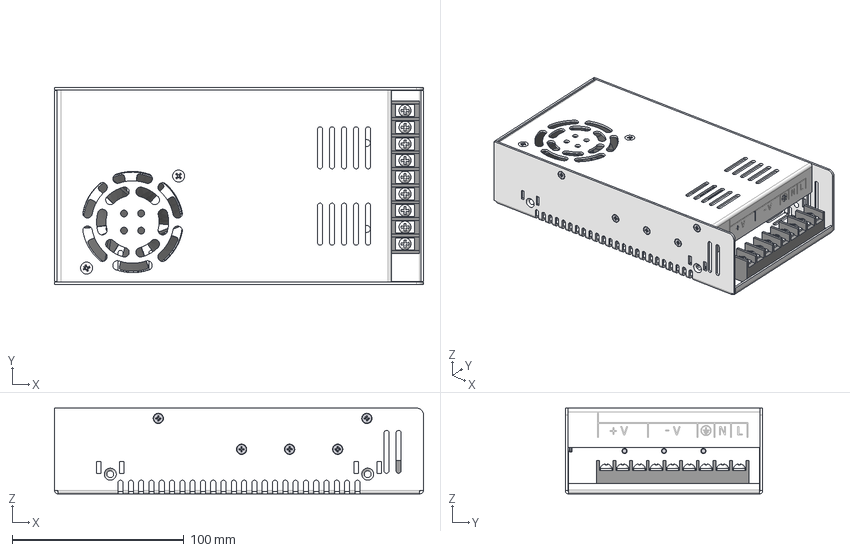
[picture p51: CAD file, 2022-03-21]
01 CAD/01 Main Model/01 Original/01 Main Model/Torno_rodillos/ELECTRONICA/Pulse power supply/Pulse_power_supply_36V_600W.stp
215.0 x 115.0 x 50.0 mm
Основание ИИП
Крышка ИИП
ISO 7046-1 - M3 x 4Z x 12
Кулер 60 х 60
Шайба 4х4х1.3 x 9
Винт M4x6 с полукруглой головкой x 9
Винт М4х12 x 2
