CharlieProjects/MULTI-19/01 CAD/01 Main Model/01 Original/01 Main Model/Torno_rodillos/ELECTRONICA/Rotary Encoder EC11/ROTARY_ENCODER_EC11.stp

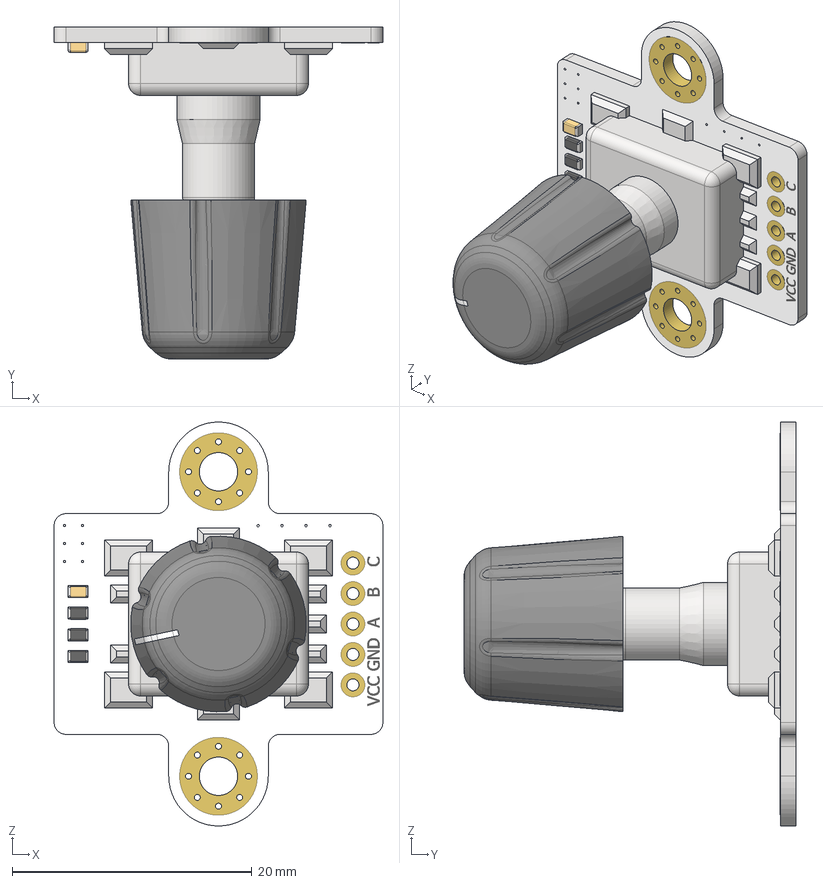
[picture p52: CAD file, 2022-03-21]
01 CAD/01 Main Model/01 Original/01 Main Model/Torno_rodillos/ELECTRONICA/Rotary Encoder EC11/ROTARY_ENCODER_EC11.stp
27.4 x 27.7 x 33.7 mm
Rotary_Encoder_EC11_1
Rotary_Encoder_EC11_TIP
