CharlieProjects/MULTI-19/01 CAD/01 Main Model/01 Original/01 Main Model/Torno_rodillos/soporte inferior ridgid -3.stl

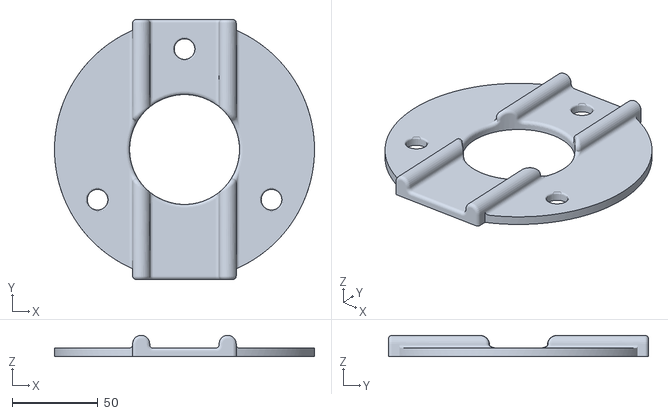
[picture p54: CAD file, 2022-03-21]
01 CAD/01 Main Model/01 Original/01 Main Model/Torno_rodillos/soporte inferior ridgid -3.stl
151.5 x 151.4 x 12.5
