CharlieProjects/MULTI-19/01 CAD/01 Main Model/02 Modified/01 Main Model/MODIFIEDASM V2/Pilot.red.Light.combine.SLDPRT

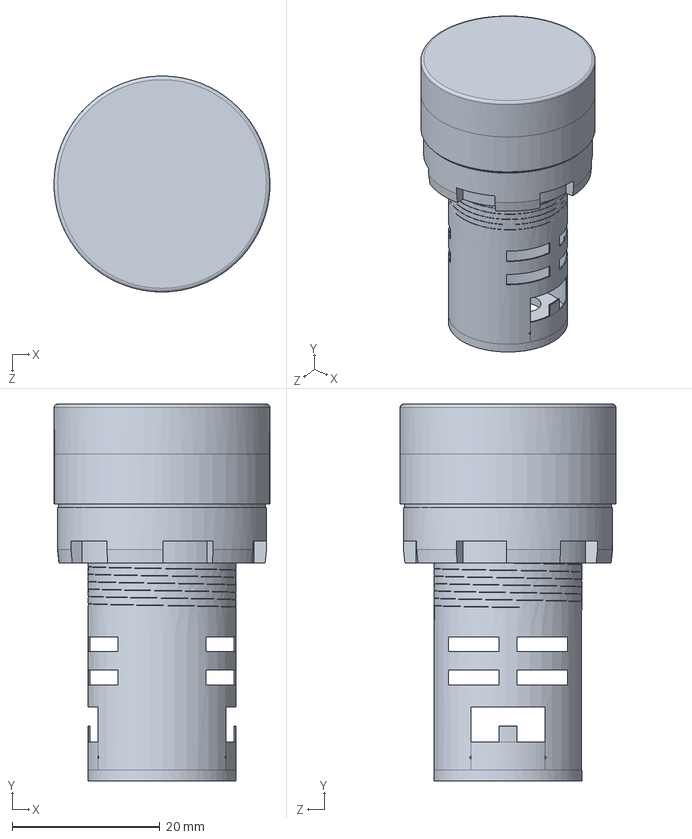
[picture p55: CAD file, 2022-03-21]
01 CAD/01 Main Model/02 Modified/01 Main Model/MODIFIEDASM V2/Pilot.red.Light.combine.SLDPRT
29.2 x 51.0 x 29.2 mm
