CharlieProjects/MULTI-19/01 CAD/01 Main Model/01 Original/01 Main Model/Torno_rodillos/ELECTRONICA/16-x-2-lcd-display-module-with-iic-i2c-module-1.snapshot.1/LCD WITH IIC/pcf8574p.SLDPRT

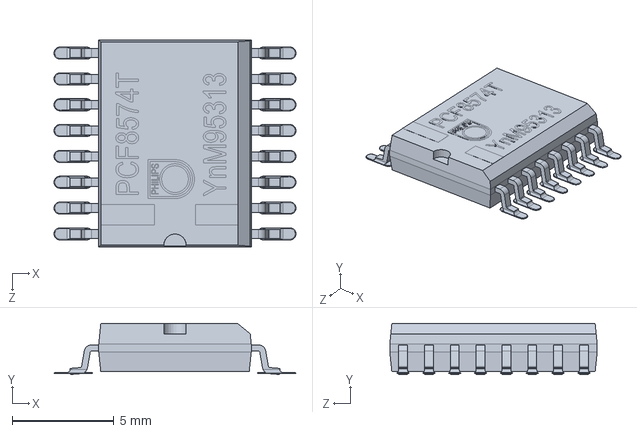
[picture p58: CAD file, 2022-03-21]
01 CAD/01 Main Model/01 Original/01 Main Model/Torno_rodillos/ELECTRONICA/16-x-2-lcd-display-module-with-iic-i2c-module-1.snapshot.1/LCD WITH IIC/pcf8574p.SLDPRT
11.9 x 2.51 x 10.2 mm
