CharlieProjects/MULTI-19/01 CAD/01 Main Model/02 Modified/01 Main Model/MODIFIEDASM V2/Gehäuse.STEP

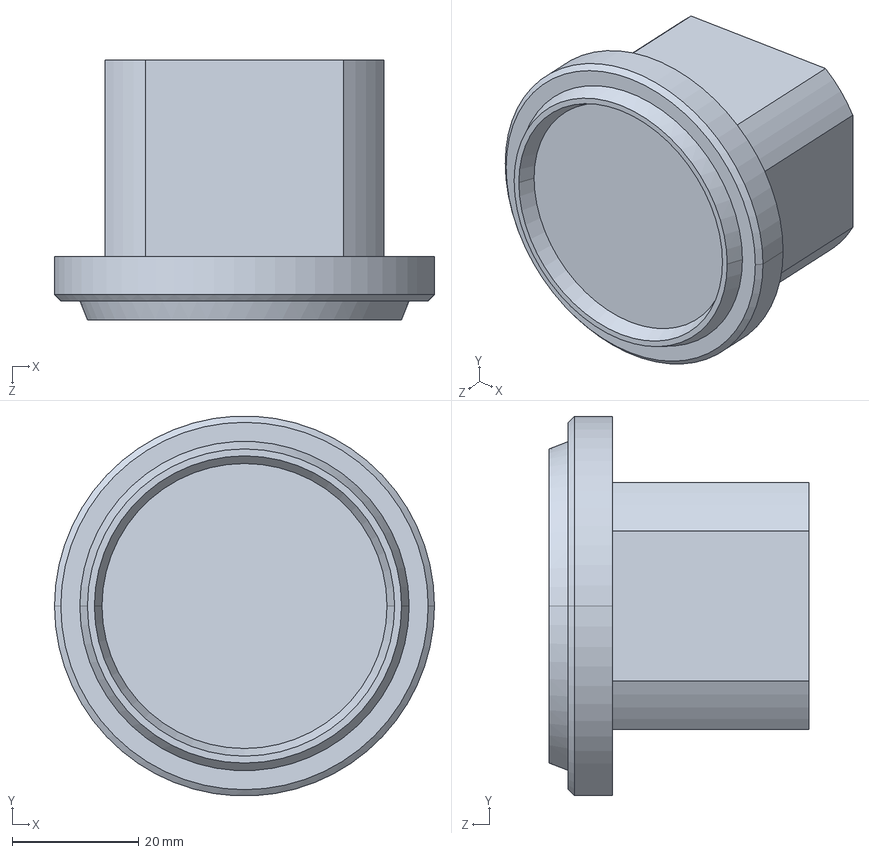
[picture p60: CAD file, 2022-03-21]
01 CAD/01 Main Model/02 Modified/01 Main Model/MODIFIEDASM V2/Gehäuse.STEP
60.0 x 59.9 x 41.0 mm
