CharlieProjects/MULTI-19/01 CAD/01 Main Model/01 Original/01 Main Model/Torno_rodillos/ELECTRONICA/HEATSINK STYLE MOUNTING PLATE, SMAKN TB6600 STEPPER MOTOR DRIVER.SLDPRT

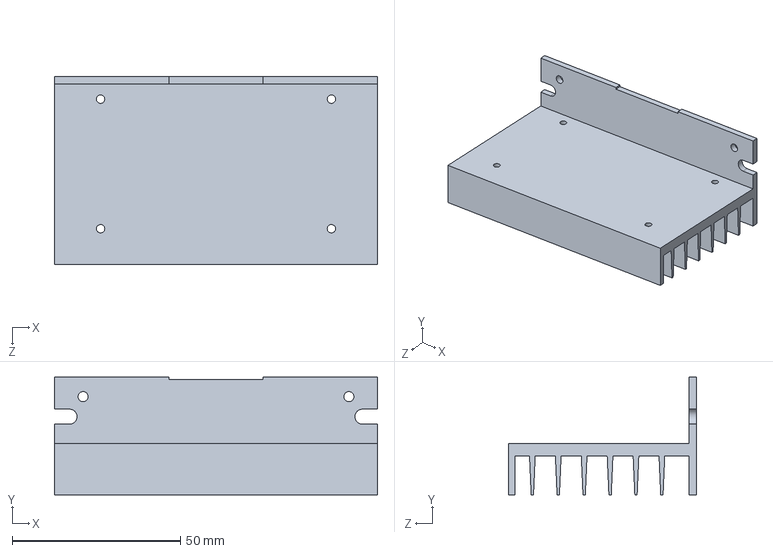
[picture p61: CAD file, 2022-03-21]
01 CAD/01 Main Model/01 Original/01 Main Model/Torno_rodillos/ELECTRONICA/HEATSINK STYLE MOUNTING PLATE, SMAKN TB6600 STEPPER MOTOR DRIVER.SLDPRT
96.0 x 35.0 x 56.0 mm
