CharlieProjects/MULTI-19/01 CAD/01 Main Model/02 Modified/01 Main Model/MODIFIEDASM V2/rl-bi004-digital-led-state-battery-charge-indicator-12v-24v-24v-36v-48v-72v-and-digital-hour-meter-1.snapshot.1/Stecker.SLDPRT

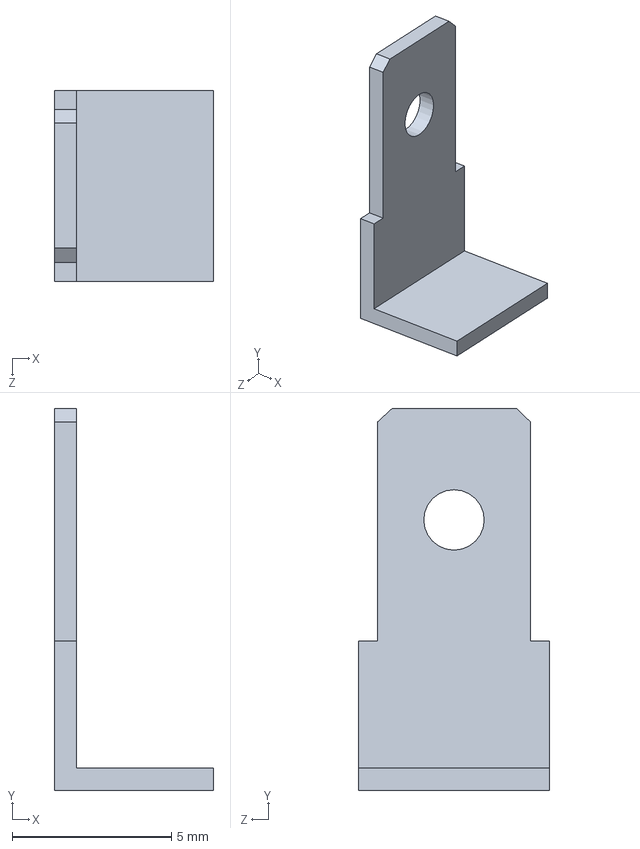
[picture p63: CAD file, 2022-03-21]
01 CAD/01 Main Model/02 Modified/01 Main Model/MODIFIEDASM V2/rl-bi004-digital-led-state-battery-charge-indicator-12v-24v-24v-36v-48v-72v-and-digital-hour-meter-1.snapshot.1/Stecker.SLDPRT
5.00 x 12.0 x 6.00 mm
