CharlieProjects/MULTI-19/01 CAD/01 Main Model/02 Modified/01 Main Model/MODIFIEDASM V2/Rotary switch.IGS

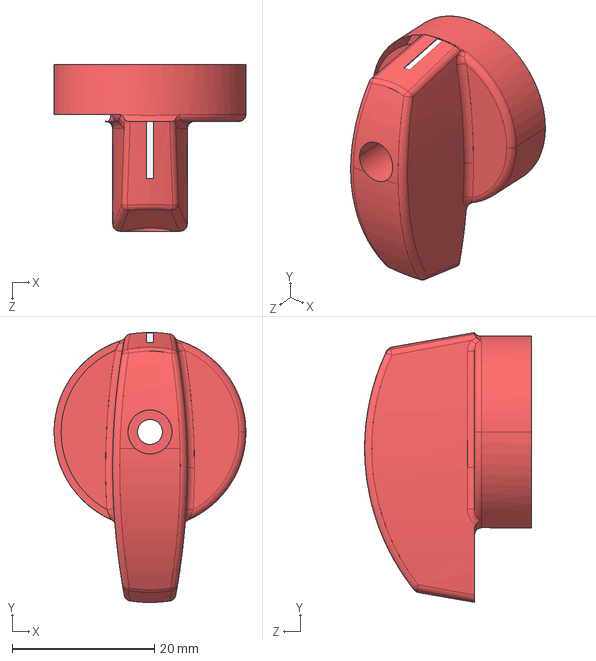
[picture p64: CAD file, 2022-03-21]
01 CAD/01 Main Model/02 Modified/01 Main Model/MODIFIEDASM V2/Rotary switch.IGS
27.0 x 38.0 x 23.5 mm
