CharlieProjects/MULTI-19/01 CAD/01 Main Model/01 Original/01 Main Model/Torno_rodillos/ELECTRONICA/SMAKN TB6600 STEPPER MOTOR DRIVER.STEP

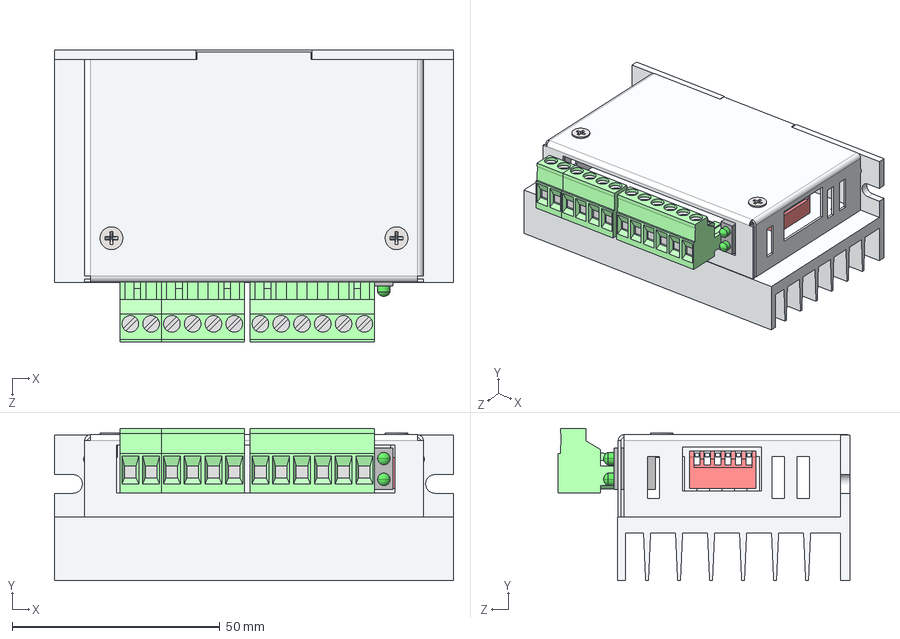
[picture p67: CAD file, 2022-03-21]
01 CAD/01 Main Model/01 Original/01 Main Model/Torno_rodillos/ELECTRONICA/SMAKN TB6600 STEPPER MOTOR DRIVER.STEP
96.0 x 36.6 x 70.3 mm
HEATSINK STYLE MOUNTING PLATE, SMAKN TB6600 STEPPER MOTOR DRIVER
SHEET METAL ENCLOSURE, SMAKN TB6600 STEPPER MOTOR DRIVER
LED BODY, SMAKN TB6600 STEPPER MOTOR DRIVER
EUROSTYLE TERMINAL BLOCK 6 POS 5.0 MM RA PLUG, SMAKN TB6600 STEPPER MOTOR DRIVER
EUROSTYLE TERMINAL BLOCK 4 POS 5.0 MM RA PLUG, SMAKN TB6600 STEPPER MOTOR DRIVER
EUROSTYLE TERMINAL BLOCK 2 POS 5.0 MM RA PLUG, SMAKN TB6600 STEPPER MOTOR DRIVER
DIP SWITCH, SMAKN TB6600 STEPPER MOTOR DRIVER
flat head screw_am_B18.6.7M - M3 x 0.5 x 6 Type I Cross Recessed FHMS --6N x 2
