CharlieProjects/MULTI-19/01 CAD/01 Main Model/01 Original/01 Main Model/Torno_rodillos/soporte inferior ridgid -2.stl

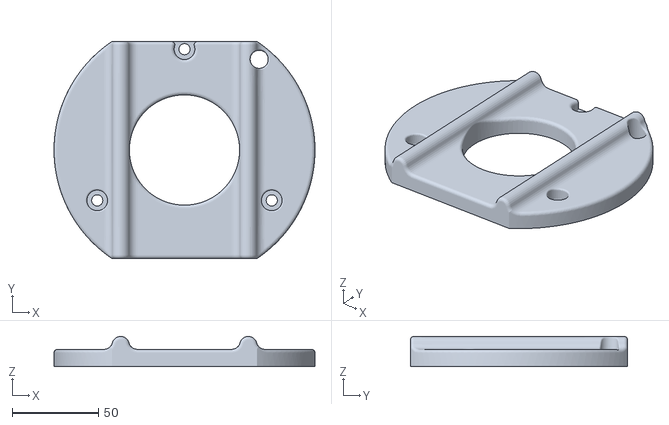
[picture p68: CAD file, 2022-03-21]
01 CAD/01 Main Model/01 Original/01 Main Model/Torno_rodillos/soporte inferior ridgid -2.stl
151.5 x 126.0 x 17.5
