CharlieProjects/MULTI-19/01 CAD/01 Main Model/02 Modified/01 Main Model/MODIFIEDASM V2/SW P3-100-EA-SWB.SLDPRT

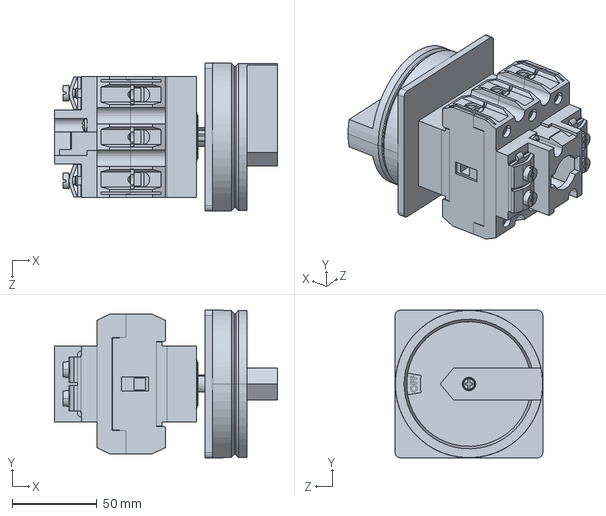
[picture p70: CAD file, 2022-03-21]
01 CAD/01 Main Model/02 Modified/01 Main Model/MODIFIEDASM V2/SW P3-100-EA-SWB.SLDPRT
131.4 x 87.0 x 87.0 mm
