CharlieProjects/MULTI-19/01 CAD/01 Main Model/02 Modified/01 Main Model/MODIFIEDASM V2/On Off Swith.STEP

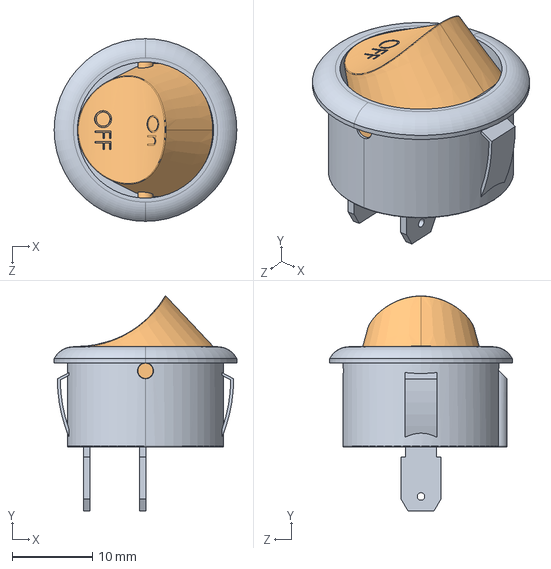
[picture p73: CAD file, 2022-03-21]
01 CAD/01 Main Model/02 Modified/01 Main Model/MODIFIEDASM V2/On Off Swith.STEP
22.8 x 26.8 x 22.8 mm
