CharlieProjects/MULTI-19/01 CAD/01 Main Model/01 Original/01 Main Model/Torno_rodillos/ELECTRONICA/LED BODY, SMAKN TB6600 STEPPER MOTOR DRIVER.SLDPRT

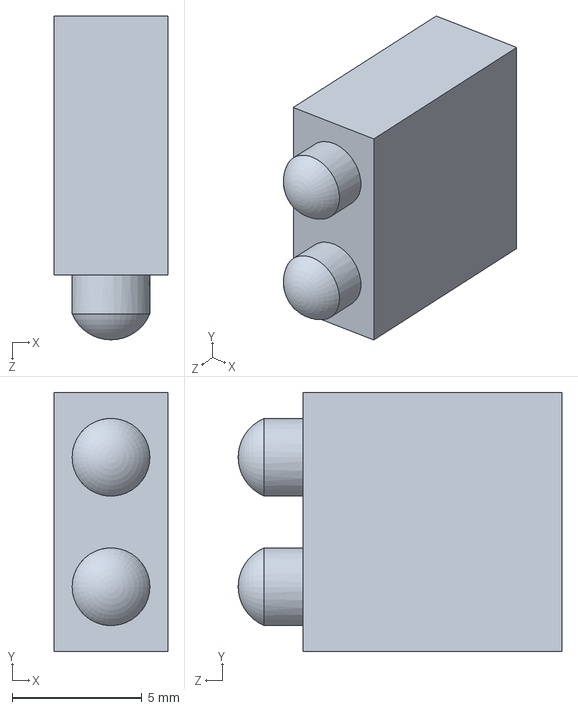
[picture p75: CAD file, 2022-03-21]
01 CAD/01 Main Model/01 Original/01 Main Model/Torno_rodillos/ELECTRONICA/LED BODY, SMAKN TB6600 STEPPER MOTOR DRIVER.SLDPRT
4.40 x 10.0 x 12.5 mm
