CharlieProjects/MULTI-19/01 CAD/01 Main Model/02 Modified/01 Main Model/MODIFIEDASM V2/Antena 3 dBi 5.8 GHz v3.step

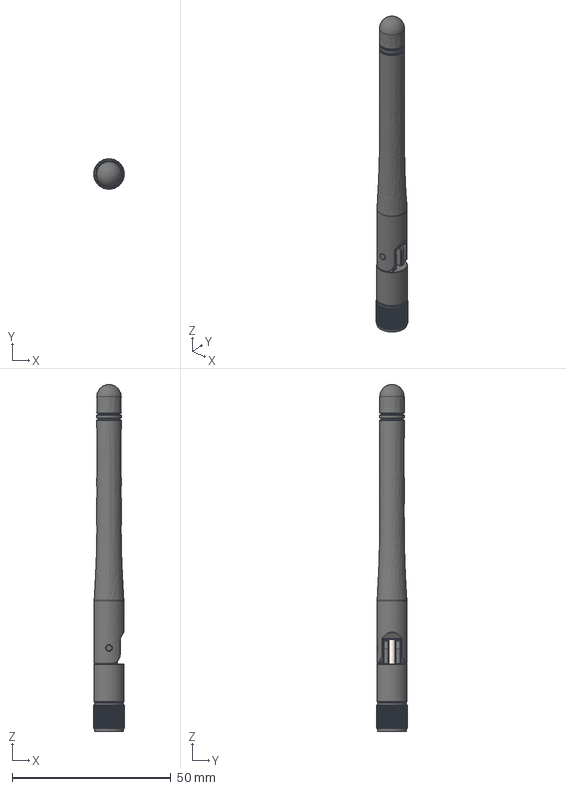
[picture p76: CAD file, 2022-03-21]
01 CAD/01 Main Model/02 Modified/01 Main Model/MODIFIEDASM V2/Antena 3 dBi 5.8 GHz v3.step
9.80 x 9.82 x 109.3 mm
Sma
Antena-1
Antena-2 x 2
Antena-stick
