CharlieProjects/MULTI-19/01 CAD/01 Main Model/01 Original/01 Main Model/Torno_rodillos/ELECTRONICA/DIP SWITCH, SMAKN TB6600 STEPPER MOTOR DRIVER.SLDPRT

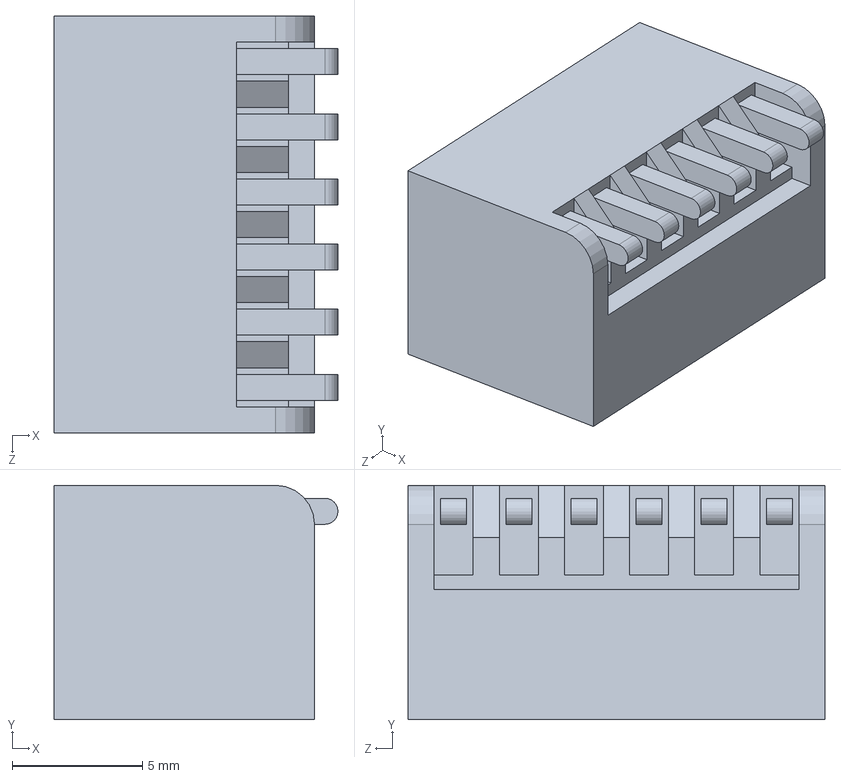
[picture p78: CAD file, 2022-03-21]
01 CAD/01 Main Model/01 Original/01 Main Model/Torno_rodillos/ELECTRONICA/DIP SWITCH, SMAKN TB6600 STEPPER MOTOR DRIVER.SLDPRT
10.9 x 9.00 x 16.0 mm
