CharlieProjects/MULTI-19/01 CAD/01 Main Model/02 Modified/01 Main Model/MODIFIEDASM V2/Rotary Switch LAY37-11X.SLDPRT

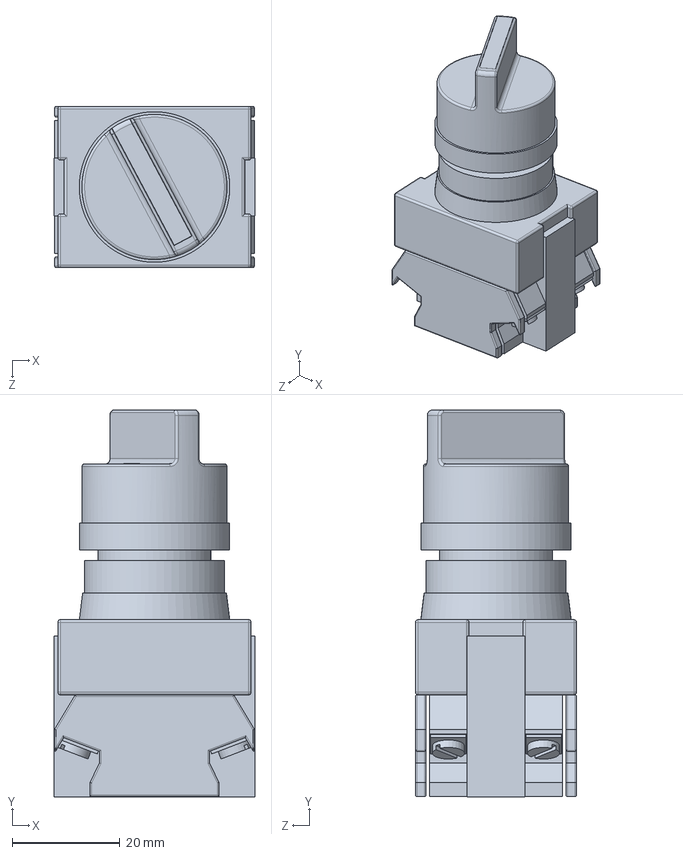
[picture p79: CAD file, 2022-03-21]
01 CAD/01 Main Model/02 Modified/01 Main Model/MODIFIEDASM V2/Rotary Switch LAY37-11X.SLDPRT
37.4 x 72.0 x 30.0 mm
