CharlieProjects/MULTI-19/01 CAD/01 Main Model/01 Original/01 Main Model/Torno_rodillos/ELECTRONICA/SHEET METAL ENCLOSURE, SMAKN TB6600 STEPPER MOTOR DRIVER.SLDPRT

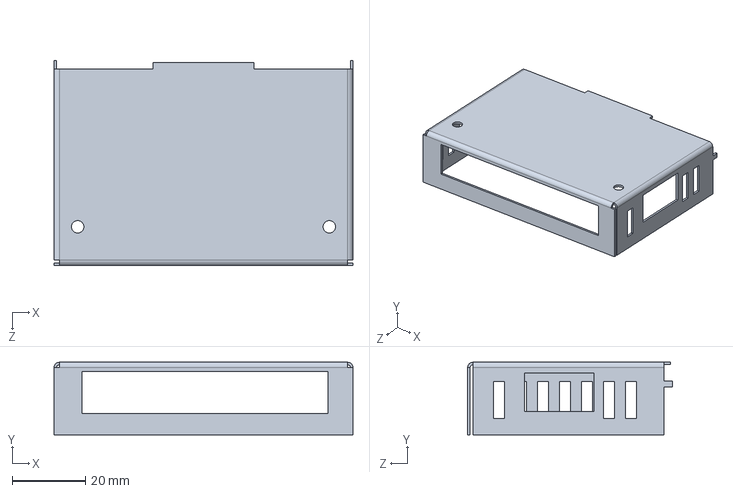
[picture p81: CAD file, 2022-03-21]
01 CAD/01 Main Model/01 Original/01 Main Model/Torno_rodillos/ELECTRONICA/SHEET METAL ENCLOSURE, SMAKN TB6600 STEPPER MOTOR DRIVER.SLDPRT
81.5 x 19.8 x 55.8 mm
