CharlieProjects/MULTI-19/01 CAD/01 Main Model/01 Original/01 Main Model/Torno_rodillos/ELECTRONICA/Power Supply S-60-12 v2.step

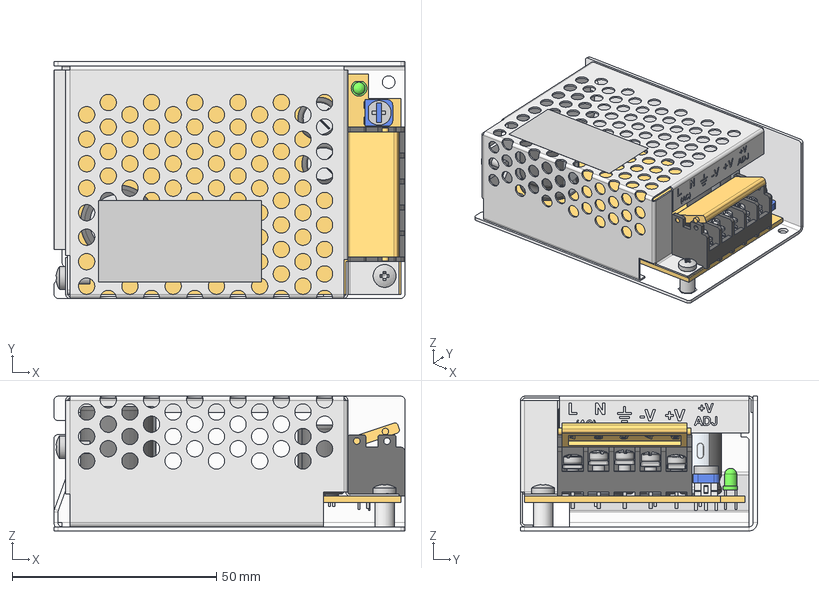
[picture p84: CAD file, 2022-03-21]
01 CAD/01 Main Model/01 Original/01 Main Model/Torno_rodillos/ELECTRONICA/Power Supply S-60-12 v2.step
86.0 x 58.0 x 33.0 mm
Base
Cover
Torretta x 2
Basetta
Corpo v2
Cover v1
DadoBasso v1 x 5
ISO 7045 - d M3 x l 6 - 4.8 - H x 5
DadoAlto v1 x 5
Pot - RES_VAR1 v1
LED 3mm Green v1
ISO 7045 - d M3 x l 6 - 4.8 - H_1
ISO 7045 - d M3 x l 6 - 4.8 - H_2
ISO 7045 - d M3 x l 6 - 4.8 - H_3
CAP_RAD_D18x20_POL_BK v1
CAP_RAD_D10x16_POL_BK v1 (1)
CAP_RAD_D10x16_POL_BK v1
Img02
Img01
