CharlieProjects/MULTI-19/(list of files, cad)

Other CAD files:
01 CAD/01 Main Model/01 Original/01 Main Model/Torno_rodillos/Guia eliptica_.dwg
01 CAD/01 Main Model/02 Modified/01 Main Model/MODIFIEDASM V2/rl-bi004-digital-led-state-battery-charge-indicator-12v-24v-24v-36v-48v-72v-and-digital-hour-meter-1.snapshot.1/Gehäuse.SLDPRT
01 CAD/01 Main Model/02 Modified/01 Main Model/MODIFIEDASM V2/Horometro.STEP
01 CAD/01 Main Model/01 Original/01 Main Model/Torno_rodillos/ELECTRONICA/carcasa.stl
01 CAD/01 Main Model/01 Original/01 Main Model/ORIGINAL_RUA/3F021115 (1).ipt
01 CAD/01 Main Model/01 Original/01 Main Model/ORIGINAL_RUA/3F021115 (10).ipt
01 CAD/01 Main Model/01 Original/01 Main Model/ORIGINAL_RUA/3F021115 (100).ipt
01 CAD/01 Main Model/01 Original/01 Main Model/ORIGINAL_RUA/3F021115 (101).ipt
01 CAD/01 Main Model/01 Original/01 Main Model/ORIGINAL_RUA/3F021115 (102).ipt
01 CAD/01 Main Model/01 Original/01 Main Model/ORIGINAL_RUA/3F021115 (103).ipt
01 CAD/01 Main Model/01 Original/01 Main Model/ORIGINAL_RUA/3F021115 (104).ipt
01 CAD/01 Main Model/01 Original/01 Main Model/ORIGINAL_RUA/3F021115 (105).ipt
01 CAD/01 Main Model/01 Original/01 Main Model/ORIGINAL_RUA/3F021115 (106).ipt
01 CAD/01 Main Model/01 Original/01 Main Model/ORIGINAL_RUA/3F021115 (107).ipt
01 CAD/01 Main Model/01 Original/01 Main Model/ORIGINAL_RUA/3F021115 (108).ipt
01 CAD/01 Main Model/01 Original/01 Main Model/ORIGINAL_RUA/3F021115 (109).ipt
01 CAD/01 Main Model/01 Original/01 Main Model/ORIGINAL_RUA/3F021115 (11).ipt
01 CAD/01 Main Model/01 Original/01 Main Model/ORIGINAL_RUA/3F021115 (110).ipt
01 CAD/01 Main Model/01 Original/01 Main Model/ORIGINAL_RUA/3F021115 (111).ipt
01 CAD/01 Main Model/01 Original/01 Main Model/ORIGINAL_RUA/3F021115 (112).ipt
01 CAD/01 Main Model/01 Original/01 Main Model/ORIGINAL_RUA/3F021115 (113).ipt
01 CAD/01 Main Model/01 Original/01 Main Model/ORIGINAL_RUA/3F021115 (114).ipt
01 CAD/01 Main Model/01 Original/01 Main Model/ORIGINAL_RUA/3F021115 (115).ipt
01 CAD/01 Main Model/01 Original/01 Main Model/ORIGINAL_RUA/3F021115 (116).ipt
01 CAD/01 Main Model/01 Original/01 Main Model/ORIGINAL_RUA/3F021115 (117).ipt
01 CAD/01 Main Model/01 Original/01 Main Model/ORIGINAL_RUA/3F021115 (118).ipt
01 CAD/01 Main Model/01 Original/01 Main Model/ORIGINAL_RUA/3F021115 (119).ipt
01 CAD/01 Main Model/01 Original/01 Main Model/ORIGINAL_RUA/3F021115 (12).ipt
01 CAD/01 Main Model/01 Original/01 Main Model/ORIGINAL_RUA/3F021115 (120).ipt
01 CAD/01 Main Model/01 Original/01 Main Model/ORIGINAL_RUA/3F021115 (121).ipt
01 CAD/01 Main Model/01 Original/01 Main Model/ORIGINAL_RUA/3F021115 (122).ipt
01 CAD/01 Main Model/01 Original/01 Main Model/ORIGINAL_RUA/3F021115 (123).ipt
01 CAD/01 Main Model/01 Original/01 Main Model/ORIGINAL_RUA/3F021115 (124).ipt
01 CAD/01 Main Model/01 Original/01 Main Model/ORIGINAL_RUA/3F021115 (125).ipt
01 CAD/01 Main Model/01 Original/01 Main Model/ORIGINAL_RUA/3F021115 (126).ipt
01 CAD/01 Main Model/01 Original/01 Main Model/ORIGINAL_RUA/3F021115 (127).ipt
01 CAD/01 Main Model/01 Original/01 Main Model/ORIGINAL_RUA/3F021115 (128).ipt
01 CAD/01 Main Model/01 Original/01 Main Model/ORIGINAL_RUA/3F021115 (129).ipt
01 CAD/01 Main Model/01 Original/01 Main Model/ORIGINAL_RUA/3F021115 (13).ipt
01 CAD/01 Main Model/01 Original/01 Main Model/ORIGINAL_RUA/3F021115 (130).ipt
01 CAD/01 Main Model/01 Original/01 Main Model/ORIGINAL_RUA/3F021115 (131).ipt
01 CAD/01 Main Model/01 Original/01 Main Model/ORIGINAL_RUA/3F021115 (132).ipt
01 CAD/01 Main Model/01 Original/01 Main Model/ORIGINAL_RUA/3F021115 (133).ipt
01 CAD/01 Main Model/01 Original/01 Main Model/ORIGINAL_RUA/3F021115 (134).ipt
01 CAD/01 Main Model/01 Original/01 Main Model/ORIGINAL_RUA/3F021115 (135).ipt
01 CAD/01 Main Model/01 Original/01 Main Model/ORIGINAL_RUA/3F021115 (136).ipt
01 CAD/01 Main Model/01 Original/01 Main Model/ORIGINAL_RUA/3F021115 (137).ipt
01 CAD/01 Main Model/01 Original/01 Main Model/ORIGINAL_RUA/3F021115 (138).ipt
01 CAD/01 Main Model/01 Original/01 Main Model/ORIGINAL_RUA/3F021115 (139).ipt
01 CAD/01 Main Model/01 Original/01 Main Model/ORIGINAL_RUA/3F021115 (14).ipt
01 CAD/01 Main Model/01 Original/01 Main Model/ORIGINAL_RUA/3F021115 (140).ipt
01 CAD/01 Main Model/01 Original/01 Main Model/ORIGINAL_RUA/3F021115 (141).ipt
01 CAD/01 Main Model/01 Original/01 Main Model/ORIGINAL_RUA/3F021115 (142).ipt
01 CAD/01 Main Model/01 Original/01 Main Model/ORIGINAL_RUA/3F021115 (143).ipt
01 CAD/01 Main Model/01 Original/01 Main Model/ORIGINAL_RUA/3F021115 (144).ipt
01 CAD/01 Main Model/01 Original/01 Main Model/ORIGINAL_RUA/3F021115 (145).ipt
01 CAD/01 Main Model/01 Original/01 Main Model/ORIGINAL_RUA/3F021115 (146).ipt
01 CAD/01 Main Model/01 Original/01 Main Model/ORIGINAL_RUA/3F021115 (147).ipt
01 CAD/01 Main Model/01 Original/01 Main Model/ORIGINAL_RUA/3F021115 (148).ipt
01 CAD/01 Main Model/01 Original/01 Main Model/ORIGINAL_RUA/3F021115 (149).ipt
01 CAD/01 Main Model/01 Original/01 Main Model/ORIGINAL_RUA/3F021115 (15).ipt
01 CAD/01 Main Model/01 Original/01 Main Model/ORIGINAL_RUA/3F021115 (150).ipt
01 CAD/01 Main Model/01 Original/01 Main Model/ORIGINAL_RUA/3F021115 (151).ipt
01 CAD/01 Main Model/01 Original/01 Main Model/ORIGINAL_RUA/3F021115 (152).ipt
01 CAD/01 Main Model/01 Original/01 Main Model/ORIGINAL_RUA/3F021115 (153).ipt
01 CAD/01 Main Model/01 Original/01 Main Model/ORIGINAL_RUA/3F021115 (154).ipt
01 CAD/01 Main Model/01 Original/01 Main Model/ORIGINAL_RUA/3F021115 (155).ipt
01 CAD/01 Main Model/01 Original/01 Main Model/ORIGINAL_RUA/3F021115 (156).ipt
01 CAD/01 Main Model/01 Original/01 Main Model/ORIGINAL_RUA/3F021115 (157).ipt
01 CAD/01 Main Model/01 Original/01 Main Model/ORIGINAL_RUA/3F021115 (158).ipt
01 CAD/01 Main Model/01 Original/01 Main Model/ORIGINAL_RUA/3F021115 (159).ipt
01 CAD/01 Main Model/01 Original/01 Main Model/ORIGINAL_RUA/3F021115 (16).ipt
01 CAD/01 Main Model/01 Original/01 Main Model/ORIGINAL_RUA/3F021115 (160).ipt
01 CAD/01 Main Model/01 Original/01 Main Model/ORIGINAL_RUA/3F021115 (161).ipt
01 CAD/01 Main Model/01 Original/01 Main Model/ORIGINAL_RUA/3F021115 (162).ipt
01 CAD/01 Main Model/01 Original/01 Main Model/ORIGINAL_RUA/3F021115 (163).ipt
01 CAD/01 Main Model/01 Original/01 Main Model/ORIGINAL_RUA/3F021115 (164).ipt
01 CAD/01 Main Model/01 Original/01 Main Model/ORIGINAL_RUA/3F021115 (165).ipt
01 CAD/01 Main Model/01 Original/01 Main Model/ORIGINAL_RUA/3F021115 (166).ipt
01 CAD/01 Main Model/01 Original/01 Main Model/ORIGINAL_RUA/3F021115 (167).ipt
01 CAD/01 Main Model/01 Original/01 Main Model/ORIGINAL_RUA/3F021115 (168).ipt
01 CAD/01 Main Model/01 Original/01 Main Model/ORIGINAL_RUA/3F021115 (169).ipt
01 CAD/01 Main Model/01 Original/01 Main Model/ORIGINAL_RUA/3F021115 (17).ipt
01 CAD/01 Main Model/01 Original/01 Main Model/ORIGINAL_RUA/3F021115 (170).ipt
01 CAD/01 Main Model/01 Original/01 Main Model/ORIGINAL_RUA/3F021115 (171).ipt
01 CAD/01 Main Model/01 Original/01 Main Model/ORIGINAL_RUA/3F021115 (172).ipt
01 CAD/01 Main Model/01 Original/01 Main Model/ORIGINAL_RUA/3F021115 (173).ipt
01 CAD/01 Main Model/01 Original/01 Main Model/ORIGINAL_RUA/3F021115 (174).ipt
01 CAD/01 Main Model/01 Original/01 Main Model/ORIGINAL_RUA/3F021115 (175).ipt
01 CAD/01 Main Model/01 Original/01 Main Model/ORIGINAL_RUA/3F021115 (176).ipt
01 CAD/01 Main Model/01 Original/01 Main Model/ORIGINAL_RUA/3F021115 (177).ipt
01 CAD/01 Main Model/01 Original/01 Main Model/ORIGINAL_RUA/3F021115 (178).ipt
01 CAD/01 Main Model/01 Original/01 Main Model/ORIGINAL_RUA/3F021115 (179).ipt
01 CAD/01 Main Model/01 Original/01 Main Model/ORIGINAL_RUA/3F021115 (18).ipt
01 CAD/01 Main Model/01 Original/01 Main Model/ORIGINAL_RUA/3F021115 (180).ipt
01 CAD/01 Main Model/01 Original/01 Main Model/ORIGINAL_RUA/3F021115 (181).ipt
01 CAD/01 Main Model/01 Original/01 Main Model/ORIGINAL_RUA/3F021115 (182).ipt
01 CAD/01 Main Model/01 Original/01 Main Model/ORIGINAL_RUA/3F021115 (183).ipt
01 CAD/01 Main Model/01 Original/01 Main Model/ORIGINAL_RUA/3F021115 (184).ipt
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
