CharlieProjects/MULTI-19/03 Electronics/PLANO TALMA CONVEYOR.pdf

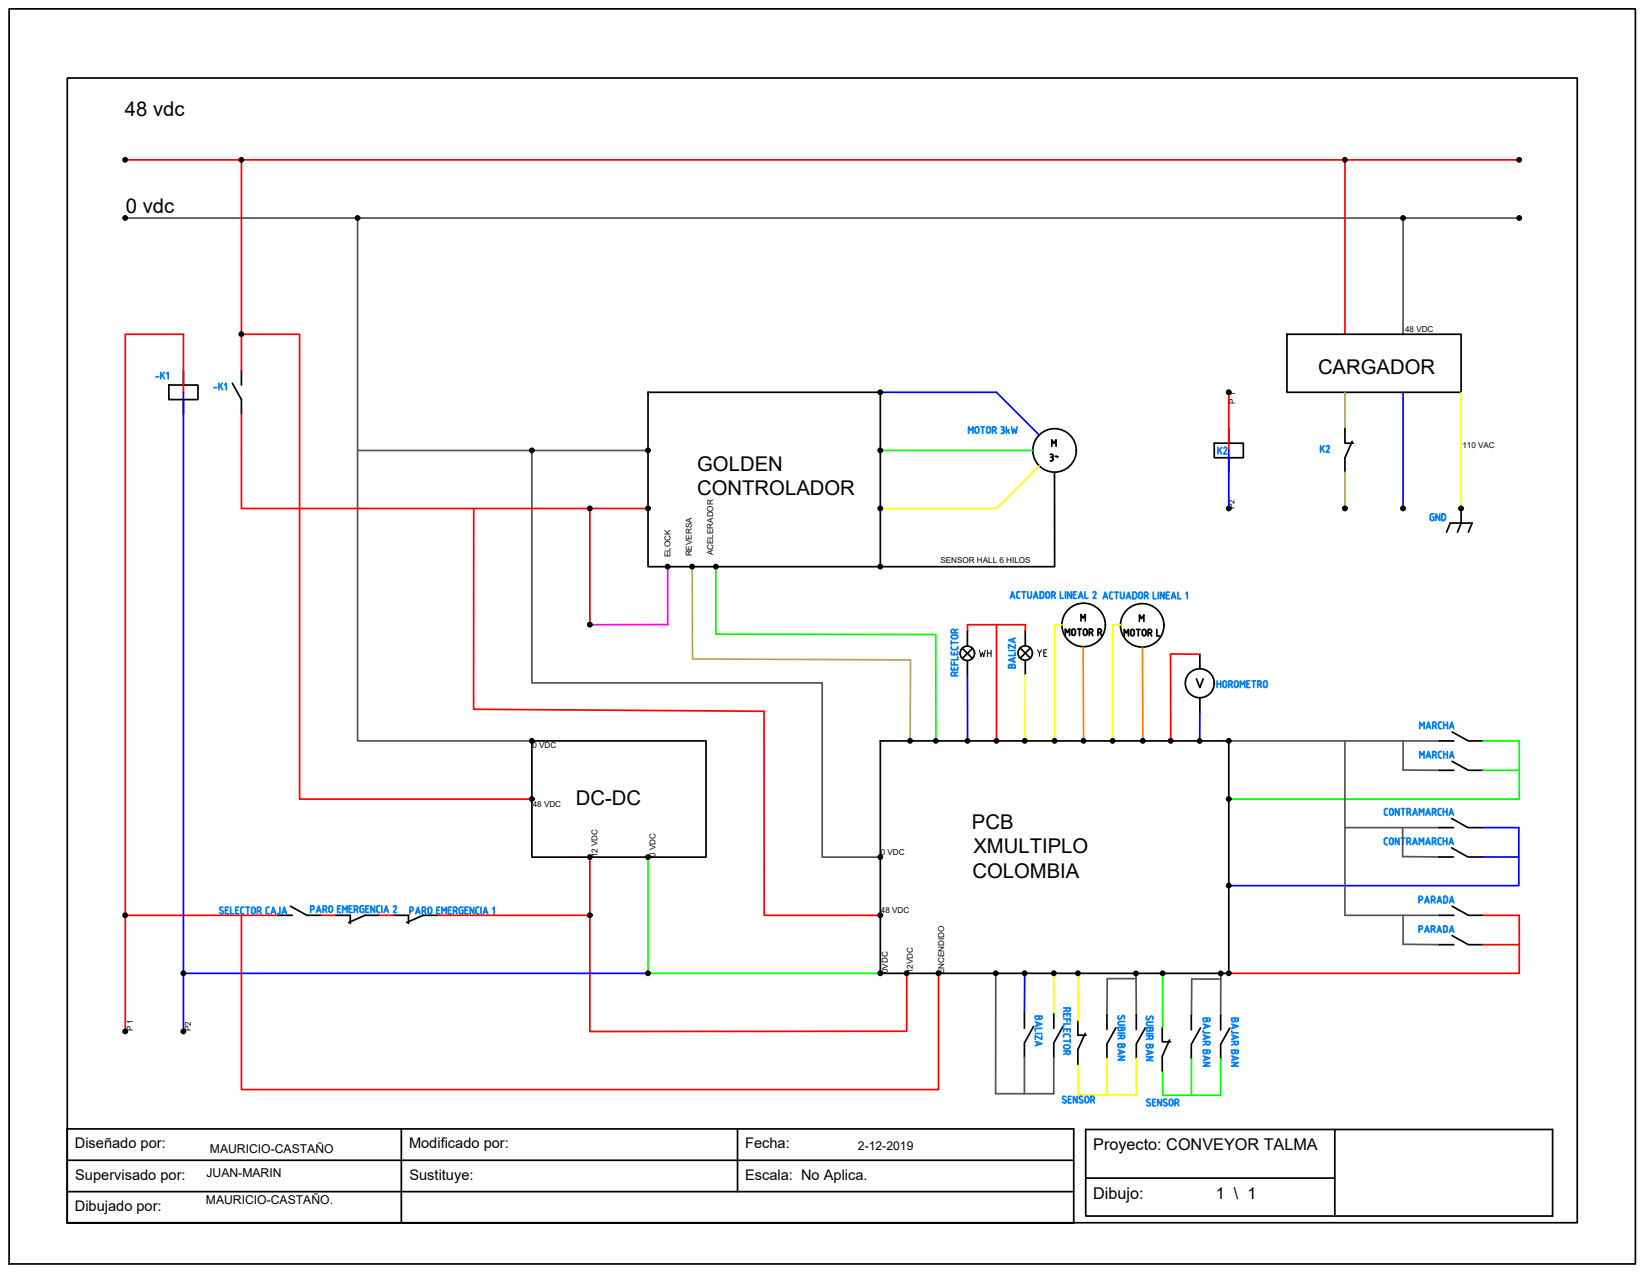
[picture p90: page 1]
Diseñado por:; Modificado por:; Fecha: Supervisado por:; Sustituye:; Escala: No Aplica. Dibujado por:; Proyecto: CONVEYOR TALMA Dibujo:; 1 \ 1 2-12-2019 MAURICIO-CASTAÑO. JUAN-MARIN MAURICIO-CASTAÑO 48 vdc 0 vdc; GOLDEN CONTROLADOR; ELOCK REVERSA; 12 VDC

0 VDC 48 VDC 0 VDC SENSOR HALL 6 HILOS CARGADOR48 VDC 110 VAC

ACELERADOR DC-DC

12VDC 48 VDC 0 VDC PCB XMULTIPLO COLOMBIA
