CharlieProjects/MULTI-19/00 Documents/01 Reports/FSM MULTI-19.pdf

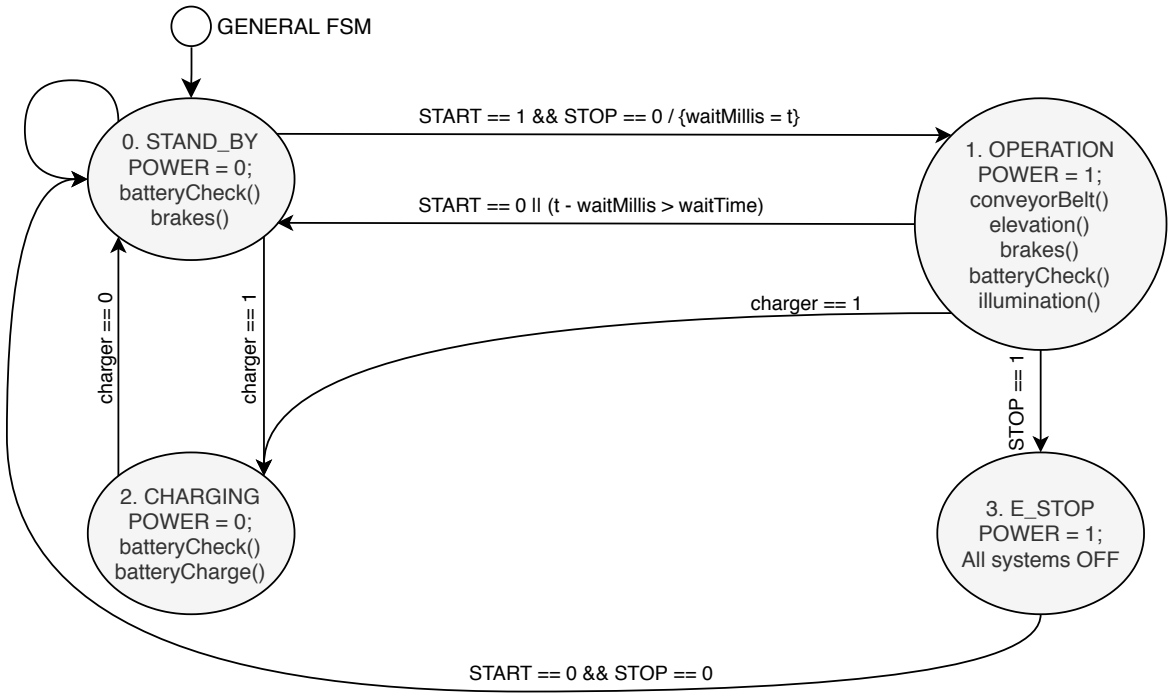
[picture p91: figure]
3. E_STOP POWER = 1; All systems OFF; 2. CHARGING POWER = 0; batteryCheck() batteryCharge(); 0. STAND_BY POWER = 0; batteryCheck() brakes(); 1. OPERATION POWER = 1; conveyorBelt() elevation() brakes() batteryCheck() illumination(); charger == 1; GENERAL FSM; START == 0 && STOP == 0; STOP == 1; charger == 0

START == 1 && STOP == 0 / {waitMillis = t}

START == 0 || (t - waitMillis > waitTime)

NOTE: "t" represents a time counting function in Arduino can be consider as the millis() function.

# FINITE SATATE MACHINE OF MULTI 19

The present document intends to diagram the logical behavior of the airport baggage lift vehicle within the schemes of a finite state machine, taking the input and output variables as a starting point to define the logical signals that activate each of the states of the different subsystems

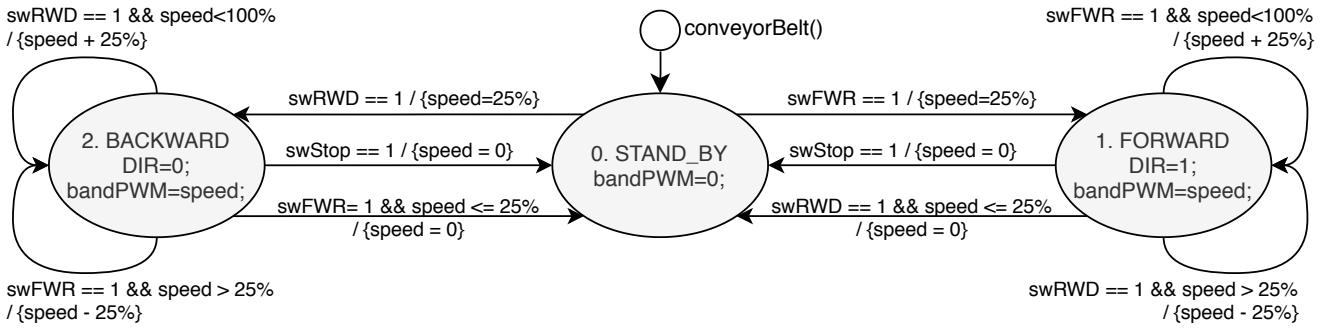
[picture p92: figure]
0. STAND_BY bandPWM=0;; 1. FORWARD DIR=1; bandPWM=speed;; 2. BACKWARD DIR=0; bandPWM=speed;; conveyorBelt(); swFWR == 1 / {speed=25%}; swFWR == 1 && speed<100% / {speed + 25%}; swStop == 1 / {speed = 0}; swRWD == 1 / {speed=25%}; swRWD == 1 && speed > 25% / {speed - 25%}; swRWD == 1 && speed<100% / {speed + 25%}; swRWD == 1 && speed <= 25% / {speed = 0}; swFWR == 1 && speed > 25% / {speed - 25%}; swFWR= 1 && speed <= 25% / {speed = 0}
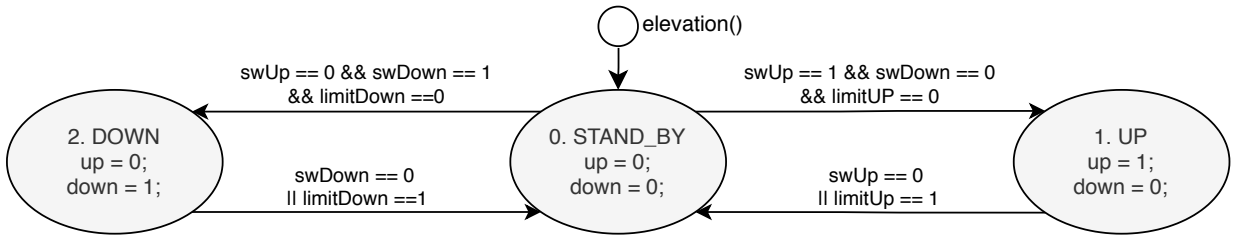
[picture p93: figure]
0. STAND_BY up = 0; down = 0;; 1. UP up = 1; down = 0;; 2. DOWN up = 0; down = 1;; elevation(); swUp == 1 && swDown == 0 && limitUP == 0; swUp == 0 && swDown == 1 && limitDown ==0; swUp == 0 || limitUp == 1; swDown == 0 || limitDown ==1

# FINITE SATATE MACHINE OF MULTI 19

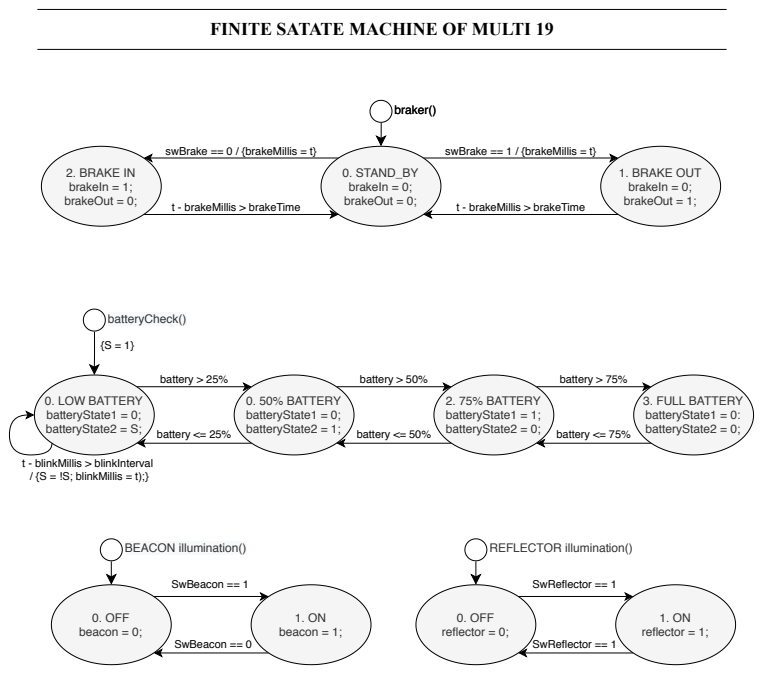
[picture p94: page 2]
0. STAND_BY brakeIn = 0; brakeOut = 0;; 1. BRAKE OUT brakeIn = 0; brakeOut = 1;; 2. BRAKE IN brakeIn = 1; brakeOut = 0;; braker(); swBrake == 0 / {brakeMillis = t}; t - brakeMillis > brakeTime; batteryCheck(); 0. LOW BATTERY batteryState1 = 0; batteryState2 = S;; battery > 25%; t - blinkMillis > blinkInterval / {S = !S; blinkMillis = t);}; 0. 50% BATTERY batteryState1 = 0; batteryState2 = 1;; 2. 75% BATTERY batteryState1 = 1; batteryState2 = 0;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
