CharlieProjects/MULTI-19/01 CAD/01 Main Model/01 Original/01 Main Model/Torno_rodillos/Guia eliptica_.pdf

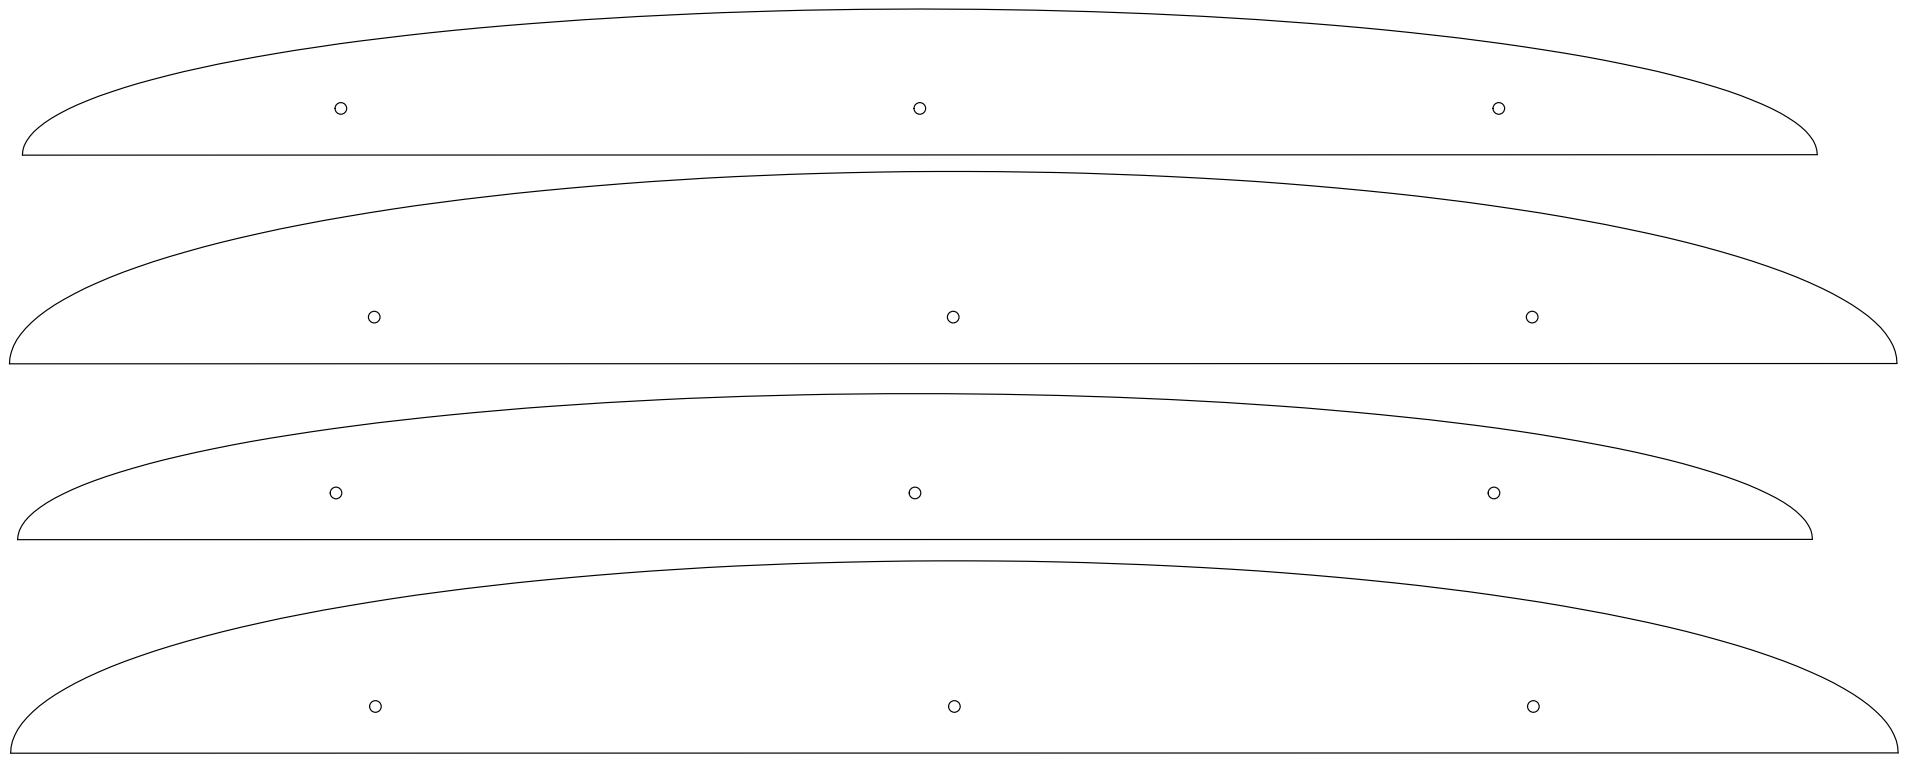
[picture p95: page 1]
