CharlieProjects/MULTI-19/(commit log)

2020-08-09 lib compatibility error debug
    [Config.h, Conveyor.h, main.cpp]
2020-08-31 Update
    lib test and error correction
    [Config.h, Conveyor.h]
2022-03-10 Reorganized folders (#2)
    The repository was reorganized to have all the different documents in one place making the folders intuitive for the CAD files, the electronic, the documentation of every component and finally the firmware files for the main controller compilation.
    The firmware its intended to be compiled on n ESP32 compatible board so far through PlatformIO.
